ImNickA/AltiumGithub/Karman Delta Arm/Ancillary Data/Vector character.png

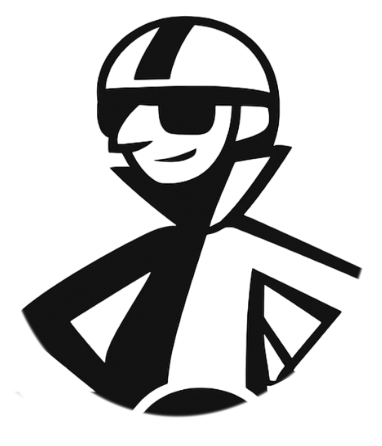
Karman Delta Arm/Ancillary Data/Vector character.png
