ImNickA/AltiumGithub/Karman Delta Arm/Ancillary Data/Altium Templates/BOM Template.xlsx

Sheet: PCB BOM
 | Bill of Materials | Field=a_BomNo
 | Title | Field=a_Title | THIS DRAWING REMAINS THE PROPERTY OF SUNRIDE. COPYRIGHT FOR ALL PURPOSES IS VESTED IN SUNRIDE. THE REPRODUCTION OF THIS DRAWING IN WHOLE OR IN PART IS PROHIBITED WITHOUT EXPRESS CONSENT IN WRITING. THIS DESIGN IS OFFERED FOR USE ONLY WITH EQUIPMENT MANUFACTURED OR SPECIFICALLY RECOMMENDED BY SUNRIDE. RIGHTS ARE RESERVED TO MAKE A CHARGE FOR THE USE OF THIS DESIGN OR ANY PART THEREOF AND SUCH RIGHT SHALL SUBSIST UNLESS AND UNTIL THE SAME SHALL BE EXPRESSLY WAIVED IN WRITING. ACCEPTANCE OF THIS DRAWING WILL BE CONSTRUED AS AN ACCEPTANCE OF THESE CONDITIONS.
 | Version | Field=a_Variant
 | Release Date: | #VALUE!
 | CAD: Altium Designer | Field=a_AltiumVer
 | Copyright | Field=a_CopyrightDate
Item # | Column=Designator | Column=Description | Column=Quantity | Column=Manufacturer Part Number 1 | Column=Manufacturer 1 | Column=Supplier Part Number 1 | Column=Supplier 1 | Column=Fitted | Column=Notes
1
2
3

Sheet: Parameters
Field=a_SchRevDate
Field=a_PcbRevDate
#VALUE! | latest of the two dates
