ImNickA/AltiumGithub/Karman Delta Arm/Rev B/Assembly Outputs/Bill of Materials/KDA Rev B1 PCB BOM.xlsx

Sheet: PCB BOM
 | Bill of Materials | KDA Rev B1
 | Title | Karman Delta V.E.C.T.O.R. Board | THIS DRAWING REMAINS THE PROPERTY OF SUNRIDE. COPYRIGHT FOR ALL PURPOSES IS VESTED IN SUNRIDE. THE REPRODUCTION OF THIS DRAWING IN WHOLE OR IN PART IS PROHIBITED WITHOUT EXPRESS CONSENT IN WRITING. THIS DESIGN IS OFFERED FOR USE ONLY WITH EQUIPMENT MANUFACTURED OR SPECIFICALLY RECOMMENDED BY SUNRIDE. RIGHTS ARE RESERVED TO MAKE A CHARGE FOR THE USE OF THIS DESIGN OR ANY PART THEREOF AND SUCH RIGHT SHALL SUBSIST UNLESS AND UNTIL THE SAME SHALL BE EXPRESSLY WAIVED IN WRITING. ACCEPTANCE OF THIS DRAWING WILL BE CONSTRUED AS AN ACCEPTANCE OF THESE CONDITIONS.
 | Version | Standard
 | Release Date: | 20 Jan 2026
 | CAD: Altium Designer | 26.2.0
 | Copyright | 2026
Item # | Designator | Description | Quantity | Manufacturer Part Number 1 | Manufacturer 1 | Supplier Part Number 1 | Supplier 1 | Fitted | Notes
1 | A1 | PCB (Bare Board) | 1 |  |  | KDA Rev B |  | Fitted | -
2 | C1A, C1B, C2A, C2B, C3A, C3B, C5A, C5B, C7A, C7B, C8A, C8B, C9A, C9B, C10A, C10B, C11A, C11B, C12A, C12B, C12C, C12D, C13A, C13B, C13C, C13D, C14, C15, C16, C18, C19 | Capacitor MLC 100nF 50V X7R 10% CAPC1608X08M | 31 | VJ0603Y104KXACW1BC | Vishay | 2407338 | Farnell | Fitted
3 | C4A, C4B | Capacitor MLC 100uF 6.3V X5R 20% CAPC2012X15M | 2 | GRM21BR60J107ME15L | Murata | 2494476 | Farnell | Fitted
4 | C6A, C6B, C17 | Capacitor MLC 10uF10V X7R 10% CAPC2012X15M | 3 | C0805C106M9RACTU | KEMET | 2821064 | Farnell | Fitted
5 | D8A, D8B | Diode Schottky BAT54C SOT-23 | 2 | BAT54C,215 | Nexperia | 1727-2902-1-ND | DigiKey | Fitted
6 | J1A, J1B, J1C, J1D | Connector 2 Way Mini-Fit 5566 Series | 4 | 39-31-0020 | Molex | 3221778 | Farnell | Fitted
7 | J2, J6 | Connector 6 Way Vertical B06B-PASK-1 (LF) (SN) 2mm Pitch | 2 | B06B-PASK-1(LF)(SN) | JST | 1830743 | Farnell | Fitted
8 | J3A, J3B, J3C, J3D | Connector 2 Way Vertical JST B2P-VH(LF)(SN) 3.96mm Pitch | 4 | B2P-VH(LF)(SN) | JST | 9492003 | Farnell | Fitted
9 | J4A, J4B, J5A, J5B | Connector 10W FFC/FPC 0.5mm SM ZIF | 4 | FH12-10S-0.5SH(55) | HIROSE ELECTRIC | 1324540 | Farnell | Fitted
10 | J7A, J7B, J9 | Connector 4 Way Vertical JST B04B-PASK-1 (LF) (SN) 2mm Pitch | 3 | B04B-PASK-1(LF)(SN) | JST | 1830738 | Farnell | Fitted
11 | J10 | Connector 3 Way Vertical 2mm Pitch | 1 | B03B-PASK-1(LF)(SN) | JST | 1830736 | Farnell | Fitted
12 | LED1A, LED1B | LED RGB, SMD, 2.4mm, 115 ° | 2 | ASMB-MTB0-0B3A2 | Avago | 3653562 | Farnell | Fitted
13 | LED2A, LED2B, LED2C, LED2D | LED 2.0x1.25mm GREEN 0805 LTST-C170KGKT | 4 | LTST-C170KGKT | Lite-On | 160-1414-1-ND | DigiKey | Fitted
14 | Q1A, Q1B, Q1C, Q1D, Q6A, Q6B, Q6C, Q6D | Power MOSFET, P Channel, 30 V, 15.2 A, 0.0111 ohm, MLPAK33, Surface Mount | 8 | PXP012-30QLJ | Nexperia | 3934789 | Farnell | Fitted
15 | Q3A, Q3B, Q3C, Q3D | N-Channel Logic Level Enhancement Mode Field Effect Transistor, 220 mA, 50 V, -55 to 150 degC, 3-Pin SOT-23, RoHS, Tape and Reel | 4 | BSS138 | onsemi | 9845330 | Farnell | Fitted
16 | R1A, R1B, R1C, R1D, R4A, R4B, R4C, R4D, R10A, R10B, R12A, R12B, R12C, R12D, R15, R37A, R37B | SMD Chip Resistor, Thin Film, 10 kohm, 75 V, 0603 [1608 Metric], 100 mW, ± 0.1%, ERA3A Series | 17 | ERA-3AEB103V | Panasonic | 1577619 | Farnell | Fitted
17 | R2A, R2B, R2C, R2D, R11A, R11B, R11C, R11D | SMD Chip Resistor, Thin Film, 30 kohm, 75 V, 0603 [1608 Metric], 100 mW, ± 0.1%, ERA3A Series | 8 | ERA-3AEB303V | Panasonic | 1670196 | Farnell | Fitted
18 | R3A, R3B, R3C, R3D | SMD Chip Resistor, Thick Film, 1 kohm, 50 V, 0603 [1608 Metric], 100 mW, ± 1%, RC Series | 4 | RC0603FR-071KL | Yageo Group | 2421849 | Farnell | Fitted
19 | R5A, R5B, R6A, R6B | Resistor 39R 1% 50V RESC1608X06M | 4 | RC0603FR-0739RL | Yageo Group | 9238310 | Farnell | Fitted
20 | R7A, R7B | Resistor 240R 1% 50V RESC1608X06M | 2 | RC0603FR-07240RL | Yageo Group | 3495779 | Farnell | Fitted
21 | R8A, R8B, R9A, R9B | Resistor 4K7 1% 50V RESC1608X06M | 4 | RC0603FR-074K7L | Yageo Group | 2421876 | Farnell | Fitted
22 | R13, R14, R16, R17 | SMD Chip Resistor, Thick Film, 62 ohm, 75V, 0603 [1608 Metric], 100mW, ± 1%, RC Series | 4 | RC0603FR-0762RL | Yageo Group | 3495893 | Farnell | Fitted
23 | R22A, R22B, R22C, R22D | Resistor 560R 1% 50V RESC1608X06M | 4 | RC0603FR-07560RL | Yageo Group | 9238450 | Farnell | Fitted
24 | SW1A, SW1B, SW2A, SW2B | Switch SMD SPST-NO Vertical ITT/Cannon KSR231GLFS | 4 | KSR231GLFS | C&K Components | 1201422 | Farnell | Fitted
25 | TP1A, TP1B, TP2A, TP2B, TP16A, TP16B, TP21, TP22 | PCB Test Point S1751 Series, Surface Mount | 8 | S1751-46R | Harwin | 952-1478-1-ND | DigiKey | Fitted
26 | U1A, U1B | IC Supply Voltage Monitor, 2.93V TPS3828-33DBVT SOT23-5 | 2 | TPS3828-33DBVR | Texas Instruments | 3008838 | Farnell | Fitted
27 | U2A, U2B | IC REG LIN 3.3V 100MA SOT223-3 | 2 | MIC5200-3.3YS-TR | Microchip | MIC5200-3.3YS-TR | Arrow Electronics | Fitted
28 | U3A, U3B, U5 | IC TRANSCEIVER FULL 1/1 8SOIC | 3 | ISO1042DWV | Texas Instruments | 296-53076-ND | DigiKey | Fitted
29 | U4 | IC Regulator LDO MIC5239-5.0YS SOT-223 | 1 | MIC5239-5.0YS | Microchip | 2510294 | Farnell | Fitted
30 | U6A, U6B | IC MCU 32BIT 16KB FLASH 32LQFP | 2 | STM32L011K4T6 | STMicroelectronics | 2770298 | Farnell | Fitted
31 | Z3A, Z3B | CABLE FFC/FPC 10POS 0.5MM 4" | 2 | 151660101 | Molex | WM11300-ND | DigiKey | Fitted

Sheet: Parameters
20 Jan 2026
20 Jan 2026
20 Jan 2026 | latest of the two dates
