ImNickA/AltiumGithub/Karman Delta Arm/Rocket arming system.xlsx

Sheet: Requirements
Req No | Requirement | Detail | Min | Typ | Max | Units | Notes
 | General
 | Operating Voltage | Suitable for 1x or 2 x LiPo cell battery packs | 3.7 |  | 10 | V
 | Current (quiescent) | Quiescent current per power domain (drawn by each uC, RS485 transceiver & LEDs). Majority of this is the RS385 transceivers & indicator LEDs |  |  | 30 | mA
 | Shock |  |  |  | TBD
 | Vibration |  |  |  | TBD
 | Temperature |  | -20 |  | 85 | °C
 | Humidity |  |  |  | TBD |  | Add conformal coating
 | Load current | Current per output channel |  |  | 3 | A
 | Number of Primary batteries |  | 2
 | Number of Primary outputs |  | 2
 | Number of Backup batteries |  | 2
 | Number of Backup outputs |  | 2
 | Distance from rocket to control PC for safety | Length of cable to be driven by RS485 | 10 |  | TBD | m | Should be able to do ~1km - depends on Baud rate. TBD
 | Isolation voltage between domains |  | 4000 |  |  | V
 | Functionality
 | Must have full electrical isolation between primary, backup and communications power domains | External event in any domain must not affect other domains |  |  |  |  | System divided into 3 totally isolated circuitry domains - Primary, Backup & comms. Any fault in one domain must not ripple through to other domains | Residual risk of ESD strike affecting flight controller & Arming PCB at same time
 | Must power up with outputs OFF by default | No voltage on outputs at any time |  |  |  |  | As batteries are connected, there must be no chance of the flight controllers being energised
 | Must boot up with outputs OFF | No voltage on outputs at any time |  |  |  |  | During uC boot, O/Ps are usually pulled Hi by high value resistor inside uC. This must not turn on the output stages
 | Must keep outputs OFF during programming / reset | No voltage on outputs at any time |  |  |  |  | During uC reset/programming, O/Ps are usually pulled Hi by high value resistor inside uC. This must not turn on the output stages
 | Must only turn outputs on when commanded
 | Must turn outputs OFF when commanded
 | Must be able to enable/disable Ultimate Arm when comms are connected | Command can be sent to enable/disable Ultimate Arm
 | Must monitor a heartbeat message sent to confirm comms is active | If comms interrupted then outputs turn OFF (unless set to Ultimate Arm) |  |  |  |  | Needed so it is safe to approach rocket - power automatically turns off if comms lost.
 | Must ignore heartbeat when in Ultimate Arm state | Ultimate Arm state maintains states of outputs even with no comms (when magnetic connector disconnects upon launch) |  |  |  |  | Needed so power is not turned off after launch when comms cable detaches
 | Must have uC status LEDs | Need to visually show what mode it is in (On, Armed, Ultimate Arm, Error etc) |  |  |  |  | RGB LEDS needed during assembly to show status. Could be switched off for launch to save power.
 | Must have output state LEDs | To indicate when a given output is switched on.
 | Must be brown our resistant | Must reset cleanly when uC voltage drops to avoid unexpected behaviour.
 | Must monitor & report all battery voltages | Transmit individual battery voltages back to control PC
 | Must power each uC (primary and backup) from diode combined batteries (only in that domain) | Diode-OR combination of each of the batteries within primary domain powers primary uC. Same for backup uC. Ensures each uC runs from the highest voltage battery in each domain
 | Must maintain independence of each battery for individual outputs | Batteries must not be combined for outputs
 | All connectors must be polarised and latching | Avoids reverse connection and prevents accidental disconnection
 | Input and output connections must be different | Avoids possibility of incorrect connection
 | Must be tolerant to reverse polarity connection of a battery | Diodes on all battery connections
 | Must maintain and transmit incrementing count of time since power applied (1 sec res) | Shows time since last reset and proves comms is alive
 | Must have debug serial port | Need to have debug serial port for SW development |  |  |  |  | Allows human readable text to be displayed on a terminal program during SW dev.
 | Must have programming header |  |  |  |  |  | Connects to STM32 programmer via pogo pins
 | PCB tracking & components must handle max short circuit current of battery pack | Current limiting to be done by battery packs |  |  |  |  | Short circuit current limit managed by battery packs
 | Control PC
 | Must allow control of individual output stages
 | Must display status of individual output stages | Show OFF / ARMED
 | Must display status of comms link | Response to heartbeat
 | Must display time since reset for each uC
 | Must display Ultimate Arm status | Show OFF / ULTIMATE ARMED
 | Must display Ultimate Arm time countdown
 | Nice To Have
 | Should be Arduino-esque | Ideally have Arduino deployed as framework for SW development

Sheet: SW Functions
Flash version No at startup on status LED
Message handling
CH1 ON
CH1 OFF
CH2 ON
CH2 OFF
CH3 ON
CH3 OFF
CH4 ON
CH4 OFF
Ultimate Arm
Ultimate disarm
Status
Heartbeat
Battery voltage measurement
Status LED
Debug serial
Output sense measurement
Heartbeat loss = disarm unless in ultimate arm

Sheet: FMEA
No | Failure Mode | Hazard | Worst case consequence | Severity Score | Likelihood score | RBM | Mitigation | Remaining Risk | Severity Score | Likelihood score | RAM | Notes
1 | Failure of Primary power domain system, causing failure of power to primary flight controller system. | Loss of function | Failed flight | 1 | 2 | 2 | Secondary power domain fully independent so secondary flight controller operates as intended | None |  |  |  | Flight controller has no safety system. Software not written to safety standards.
2 | Failure of arming system causes unintended O/P activation |  |  |  |  | 0
3 | Failure of comms |  |  |  |  | 0
4 | Battery goes flat |  |  |  |  | 0
5 | Launch before ultimate arming of O/Ps - so O/Ps go off when comms failure detected |  |  |  |  | 0 | Launch checklist
6 | Launch before top stage ready |  |  |  |  | 0
7 |  |  |  |  |  | 0
8 |  |  |  |  |  | 0
9 |  |  |  |  |  | 0
10 |  |  |  |  |  | 0
11 |  |  |  |  |  | 0
12 |  |  |  |  |  | 0
13 |  |  |  |  |  | 0
14
 |  |  | Low Severity or Low Liklihood | 1
 |  |  |  | 2
 |  |  |  | 3
 |  |  |  | 4
 |  |  | High Severity or High Liklihood | 5
 |  |  | <=2 = OK
 |  |  | >2 = Med
 |  |  | >9 = High

Sheet: TO DO
To Do | Done | Notes
Add programming connector | a
Add O/P senses to uC | a
Check Load Currents | a
Add status LED & O/P state LEDs | a
Add POR | a
MCAD link | r
Add mating connectors in unmated positions in 3D | r
Add PCB part No inc BOM entry | a
Add layer idents | a
Back annotate | r
Consider board shape - leaving cutout to allow removal without disassembling rocket centre tube. | r
Add gate pot down resistors to protect P fet Vgs | a
Add decouplers to Vsense lines | a
Check ADC I/P Z
Sort multiple symbols for same parts | a
Change 0.1% resistor symbol to rectangle | a
Add PCB templates | a
Sort pull down resistors (internal uC pull up is nominal 45K, 25K min) | a
Add CAN line terminators | a
Add conformal coating layers | r
Sort Outjobs | a
Redo board shape to allow for external switches & debug headers | a
Change P FETS to higher current devices | a
Change mounting holes to isolated | r
Add domain ident blob links | a
Sort problems with Tag Connect footprint - keepouts & mech size | a
Finish tracking | a
Full rules check | a
Routing layer 2mm cutter tool path | a
Drawing notes | a
PCB Number - change from XXXXXX | a
Sort designators | a
Sort assembly layer designators | a
Get standard stackup from PCB manuf | a
Sort BomDoc | a
Sort BOM Excel template | a
Remove parts under compile mask | a
Setup rules re domain separation | r
Small gap to pass wires through (middle of iso area) | a
Tent vias | a
Stitching vias | r
Solder blobs showing as short circuit and not working with copper pour | a
Turn back on rules temporarily disabled | a
Investigate CAN | a
Label Inputs & Outputs | a
Check Poly Fills for unconnected copper | a
Redo logo cutout to increase breakout size | a
Sort route tool path for centre hole | a

Sheet: Problems
Problem | Details | Identified by Initials & Date | Problem Found In | Fixed by Initial & Date | Problem Fixed In | Notes
Spelling on Keyfob | Should read "Karman Delta" | ACB 15 Dec 2025 | Rev A | ACB 28 Dec 2025 | Rev B
Magnitude and direction | Should read Direction and Magnitude | ACB 15 Dec 2025 | Rev A | ACB 28 Dec 2025 | Rev B
C8B | Too close to through hole metal pin of programming header | ACB 15 Dec 2025 | Rev A | ACB 28 Dec 2025 | Rev B
D8B | Overlaps connector | ACB 15 Dec 2025 | Rev A | ACB 28 Dec 2025 | Rev B
U3B | Designator visible - overlaps pads | ACB 15 Dec 2025 | Rev A | ACB 28 Dec 2025 | Rev B
OUT_P1 | Silkscreen truncated | ACB 15 Dec 2025 | Rev A | ACB 28 Dec 2025 | Rev B
Ancillaries schematic template | Bottom left logo wrong | ACB 15 Dec 2025 | Rev A | ACB 28 Dec 2025 | Rev B
Via tenting | Not all vias tented | ACB 15 Dec 2025 | Rev A | ACB 19 Jan 2026 | Rev B
Board edge clearance | Tracks & holes too close to board edge. Create new rule | ACB 15 Dec 2025 | Rev A | ACB 1 Jan 2026 | Rev B
Blob links unnecessary | Remove blob links | ACB 15 Dec 2025 | Rev A | ACB 10 Jan 2026 | Rev B
PFETs wrong | Drain Source swapped on symbol | ACB 15 Dec 2025 | Rev A | ACB 10 Jan 2026 | Rev B
3V3 connection on serial debug | PCB 3V3 clash with 3V3 from FTDI lead - disconect | ACB 15 Dec 2025 | Rev A | ACB 10 Jan 2026 | Rev B
Programming adaptor breakout | RX TX crossed - rewire | ACB 15 Dec 2025 | Rev A | ACB 10 Jan 2026 | Rev B
Status LED too bright | Reduce current in all RGB LEDs | ACB 15 Dec 2025 | Rev A | ACB 10 Jan 2026 | Rev B
Concern about bulk capacitance | Increase C4 to 100uF | ACB 15 Dec 2026 | Rev A | ACB 10 Jan 2026 | Rev B
Check Net Class directives on SCM | Had been corrupted. Needs to be re-entered | ACB 15 Dec 2026 | Rev A | ACB 10 Jan 2026 | Rev B
Sort BOM - new parts | Add part solutions | ACB 15 Dec 2026 | Rev A | ACB 19 Jan 2026 | Rev B
CAN adaptor 9V I/P | Needs connector rather than test points | ACB 15 Dec 2026 | Rev A | ACB 11 Jan 2026 | Rev B
Dates
Conformal coating | Add conformal coating mask layers to assembly drawings | ACB 15 Dec 2025 | Rev A
NOT GOING TO CHANGE NOW
Surge current | Check e-match igniton current profile | ACB 15 Dec 2025 | Rev A |  |  | 2A for 4mS. FETs ok, but need to check battery voltage dip during firing. Would be alieviated by using both batteries on primary and secondary (ie 4 batteries)
Brown out reset | Check uC bulk capacitance needed | ACB 15 Dec 2025 | Rev A |  |  | As above
Cost of multiple designs per PCB | Only do main PCB - delete ancillaries & keyfob | ACB 15 Dec 2025 | Rev A
CAN connector | Could split out each CAN bus and link in external connector. Thereby breaking the link between the processors as flight starts. Use existing 6 way connector. NEED TO CHANGE CAN ADAPTOR ALSO | ACB 15 Dec 2025 | Rev A
CAN peripheral not on current uC | Can peripheral on uC would make programming comms easier | ACB 15 Dec 2025 | Rev A
Boot address | Check default boot address so don't have to set option bytes. Possibly invert BOOT | ACB 15 Dec 2025 | Rev A |  |  | Easier to just add note on schematic to program Option Bits
Camera connector | Add 2 way header via 1k resistor | ACB 15 Dec 2025 | Rev A |  |  | Ground box doesn't have ability to switch this

Sheet: Bits to purchase
Item | Qty | Manuf | Manuf Part No | Supplier | Supplier Part No | Link | Notes | Ordered
M8 Nut - Reny | 2 | ACCU | HPN-M8-RENY-BL | ACCU | HPN-M8-RENY-BL | https://www.accu.co.uk/hexagon-nuts/655625-HPN-M8-RENY-BL | M8 glass reinforced Nylon - non conductive nut | r
Battery pack connector receptacle | 4 | Molex | 39012025 | Farnell | 2101989 | https://uk.farnell.com/molex/39-01-2025/connector-housing-rcpt-2pos/dp/2101989 | Mates with 39-31-0020 Molex MiniFit Jnr | a
Battery pack crimp | 8 | Molex | 45750-1112 | Farnell | 1717550 | https://uk.farnell.com/molex/45750-1112/contact-socket-18awg-crimp/dp/1717550 |  | Already got
Output connector receptacle | 4 | JST | VHR-2N | Farnell | 630470 | https://uk.farnell.com/jst-japan-solderless-terminals/vhr-2n/crimp-housing-2way-3-96mm/dp/630470 | Mates with B2P-VH(LF)(SN) JST VH Series | a
Output crimp | 8 | JST | BVH-21T-P1.1 | Farnell | 630500 | https://uk.farnell.com/jst-japan-solderless-terminals/bvh-21t-p1-1/crimp-socket-0-33-0-83mm/dp/630500 |  | a
CAN connector receptacle | 1 | JST | PAP-06V-S | Farnell | 1830730 | https://uk.farnell.com/jst-japan-solderless-terminals/pap-06v-s/connector-housing-pa-6way-2mm/dp/1830730 | Mates with B06B-PASK-1 (LF) (SN) JST PA series | a
CAN crimp | 6 | JST | SPHD-002T-P0.5 | Farnell | 1830725 | https://uk.farnell.com/jst-japan-solderless-terminals/sphd-002t-p0-5/crimp-socket-24-28awg/dp/1830725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 |  | Already got
Serial connector receptacle | 3 | JST | PAP-04V-S | Farnell | 1830729 | https://uk.farnell.com/jst-japan-solderless-terminals/pap-04v-s/connector-housing-rcpt-4pos-2mm/dp/1830729 | Mates with B04B-PASK-1 (LF) (SN) 4 JST PA series | Already got
Serial crimp | 12 | JST | SPHD-002T-P0.5 | Farnell | 1830725 | https://uk.farnell.com/jst-japan-solderless-terminals/sphd-002t-p0-5/crimp-socket-24-28awg/dp/1830725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 |  | Already got
PP3 battery clip | 1 |  |  |  |  |  |  | a
Dev Kit
ST-Link programmer | 1 | ST Micro | ST-LINK/V2 | Farnell | 1892523 | https://uk.farnell.com/stmicroelectronics/st-link-v2/icd-programmer-for-stm8-stm32/dp/1892523
Adaptor PCB | 1 | Tag Connect | ARM20-CTX | Debug Store | ARM20-CTX | https://thedebugstore.com/products/tag-connect-arm20-ctx-20-pin-to-tc2030-idc-adapter-uk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
Tag Connect programming header | 1 | Tag Connect | TC2030-CTX-NL-ST14 | Debug Store | TC2030-CTX-NL-ST14 | https://thedebugstore.com/products/tag-connect-tc2030-ctx-nl-st14-stm32-swd-programming-cable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
USB to serial lead | 3 | FTDI | TTL-232RG-VREG3V3-WE | Farnell | 2352005 | https://uk.farnell.com/ftdi/ttl-232rg-vreg3v3-we/cable-ttl-usb-conv-wire-end-3v3/dp/2352005 | NO STOCK
Dev boards | 2 | ST Micro | Nucleo-L011K4 | Farnell | 2535699 | https://uk.farnell.com/stmicroelectronics/nucleo-l011k4/dev-board-nucleo-32-mcu/dp/2535699 |  | a
Consumables
Flux pen |  | CHEMTRONICS | CW8400 | Farnell | 9599568 | https://uk.farnell.com/chemtronics/cw8400/dispensing-pen-flux-lead-free/dp/9599568
Solder |  |  |  |  |  |  | 60/40 Sn/Pb
Flux-off |  | CHEMTRONICS | ES835BE | Farnell | 860414 | https://uk.farnell.com/chemtronics/es835be/cleaner-flux-off-200ml/dp/860414
Lint free cloths |  | MULTICOMP PRO | MP015562 | Farnell | 4668791 | https://uk.farnell.com/multicomp-pro/mp015562/clean-room-wiper-100x100mm-150sheet/dp/4668791
Anti-static bags (metalised)
Cotton buds (wooden)
Peelable Mask |  | TECHSPRAY | 2211-8SQ | Farnell | 2501338 | https://uk.farnell.com/techspray/2211-8sq/solder-mask-peelable-wondermask/dp/2501338 | For masking connectors & switches before conformal coating
Conformal coating |  | ELECTROLUBE | APL400H | Farnell | 3026838 | https://uk.farnell.com/electrolube/apl400h/coating-conformal-acrylic/dp/3026838 | Acrylic Protective Lacquer
Threadlock 222 |  | Loctite | 222, 10ML | Farnell | 537056 | https://uk.farnell.com/loctite/222-10ml/threadlocker-bottle-10ml-purple/dp/537056 | Keeps nut in place - saves having to over-tighten
IPA |  |  |  |  |  |  | Iso-Propyl Alcohol
Solder Wick
Tip Cleaner/Tinner
Brass wire tip cleaner
Tools
Tweezers |  | WELLER EREM (https://uk.farnell.com/c/tools-production-supplies/tools-hand-workholding/tweezers?brand=weller-erem) | 5SASL | Farnell | 1014356 | https://uk.farnell.com/erem/5sasl/tweezer-economic-115mm/dp/1014356 | Fine tip
Loupes |  |  |  | Ebay |  | https://www.ebay.co.uk/itm/388292280633 | Use x3.5 magnification

Sheet: Ignitor current
Current profile of ignitors
 | #1 | #2 | #3 | Firing run
DC resistance measured on DVM (Ω) | 2.28 | 2.13 | 2.22 | #1
lead set (Ω) to be subtracted | 0.75 | 0.75 | 0.75
Ignitor (Ω) | 1.53 | 1.38 | 1.47
 |  |  |  | #2
 |  |  |  | #3

Sheet: Lessons Learned
Problem | Root Cause | Possible avoidance measures | Notes

Sheet: Calculations
O/P LED resistor
LED Forward voltage (V) | 2
Supply voltage (V) | 7.4
LED current (mA) | 10
Load resistor (Ohm) | 540
Resistor power (W) | 0.054
O/P voltage sense
Top R (KOhm) | 30
Bottom R (KOhm) | 10
Out Voltage (V) | 7.4
Sense Voltage (V) | 1.85
RGB LED | R | G | B
LED Forward voltage (V) | 2.1 | 3.1 | 3.1
Supply voltage (V) | 3.3 | 3.3 | 3.3
LED current (mA) | 5 | 5 | 5
Load resistor (Ohm) | 240 | 40 | 40
Resistor power (W) | 0.006 | 0.001 | 0.001
Capacitance for firing |  |  | Capacitance needed to source O/P current
Firing current (A) | 2
Firing Duration (mS) | 4
Voltage dip (V) | 0.1
Capacitance required (F) | 0.08 |  | Not going to add that much capacitance - is better done by having secondary battery
Capacitance required (uF) | 80000 |  | I=CdV/dt | C=Idt/dV
uC bulk capacitance |  |  | Capacitance needed on 3V3 line to prevent uC brown out during firing
uC current (A) | 0.05
Firing Duration (mS) | 4
Voltage dip (V) | 0.1
Capacitance required (F) | 0.002
Capacitance required (uF) | 2000 |  | Not going to add that much capacitance - is better done by having secondary battery
Firing current limiting |  |  | Add resistance to ignitor lead to reduce current surge from battery
Ignitor resistance (ohm) | 1.6
Ignitor firing current (A) | 0.4
Battery voltage (V) | 3.7
Total resistance needed | 9.25 |  | Total circuit resistance to draw ignitor current
Series R needed (ohm) | 7.65 |  | Resistance to add in series with ignitor
 |  |  |  |  | c

Sheet: uC pinout
Pin number |  |  |  |  |  |  | Pin name (function after reset) | Pin type | I/O structure | Notes | Pin functions
TSSOP14 | UFQFPN20 | TSSOP20 | UFQFPN28 | LQFP32 | UFQFPN32 (1) | WLCSP25 |  |  |  |  | Alternate functions | Additional functions | Usage
2 | 1 | 2 | 2 | 2 | 2 | B5 | PC14- | I/O | FT | - | - | OSC32_IN | OUT_EN_6
 |  |  |  |  |  |  | OSC32_IN
3 | 2 | 3 | 3 | 3 | 3 | C5 | PC15- | I/O | TC | - | - | OSC32_OUT | LED_RED
 |  |  |  |  |  |  | OSC32_OUT
4 | 3 | 4 | 4 | 4 | 4 | D5 | NRST | I/O | RST | -2 | - | -
10 | 4 | 5 | 5 | 5 | 5 | C4 | VDDA | S | - | (3)(4) | - | -
5 | 5 | 6 | 6 | 6 | 6 | E5 | PA0-CK_IN | I/O | TTa | - | USART2_RX, | COMP1_INM, | LED_GREEN
 |  |  |  |  |  |  |  |  |  |  | LPTIM1_IN1, | ADC_IN0,
 |  |  |  |  |  |  |  |  |  |  | TIM2_CH1, | RTC_TAMP2/WKU
 |  |  |  |  |  |  |  |  |  |  | USART2_CTS, TIM2_ETR, | P1/CK_IN
 |  |  |  |  |  |  |  |  |  |  | LPUART1_RX,
 |  |  |  |  |  |  |  |  |  |  | COMP1_OUT
6 | 6 | 7 | 7 | 7 | 7 | B4 | PA1 | I/O | FT | - | EVENTOUT, | COMP1_INP,
 |  |  |  |  |  |  |  |  |  |  | LPTIM1_IN2, | ADC_IN1
 |  |  |  |  |  |  |  |  |  |  | TIM2_CH2,
 |  |  |  |  |  |  |  |  |  |  | I2C1_SMBA,
 |  |  |  |  |  |  |  |  |  |  | USART2_RTS_DE,
 |  |  |  |  |  |  |  |  |  |  | TIM21_ETR,
 |  |  |  |  |  |  |  |  |  |  | LPUART1_TX
- | - | 8 | 8 | 8 | 8 | D4 | PA2 | I/O | TTa | - | TIM21_CH1, TIM2_CH3, | COMP2_INM,
 |  |  |  |  |  |  |  |  |  |  | USART2_TX, | ADC_IN2, | BATT_SENSE_5
 |  |  |  |  |  |  |  |  |  |  | LPUART1_TX, | RTC_TAMP3/RTC_
 |  |  |  |  |  |  |  |  |  |  | COMP2_OUT | TS/RTC_OUT/WKU P3
- | - | 9 | 9 | 9 | 9 | E4 | PA3 | I/O | FT | - | TIM21_CH2, | COMP2_INP,
 |  |  |  |  |  |  |  |  |  |  | TIM2_CH4, | ADC_IN3
 |  |  |  |  |  |  |  |  |  |  | USART2_RX,
 |  |  |  |  |  |  |  |  |  |  | LPUART1_RX
7 | 7 | 10 | 10 | 10 | 10 | B3 | PA4 | I/O | TTa | - | SPI1_NSS, | COMP1_INM,
 |  |  |  |  |  |  |  |  |  |  | LPTIM1_IN1, | COMP2_INM,
 |  |  |  |  |  |  |  |  |  |  | LPTIM1_ETR, I2C1_SCL, | ADC_IN4 | BATT_SENSE_1
 |  |  |  |  |  |  |  |  |  |  | USART2_CK,
 |  |  |  |  |  |  |  |  |  |  | TIM2_ETR,
 |  |  |  |  |  |  |  |  |  |  | LPUART1_TX,
 |  |  |  |  |  |  |  |  |  |  | COMP2_OUT
- | 8 | 11 | 11 | 11 | 11 | D3 | PA5 | I/O | TTa | - | SPI1_SCK, | COMP1_INM,
 |  |  |  |  |  |  |  |  |  |  | LPTIM1_IN2, | COMP2_INM,
 |  |  |  |  |  |  |  |  |  |  | TIM2_ETR, | ADC_IN5 | BATT_SENSE_2
 |  |  |  |  |  |  |  |  |  |  | TIM2_CH1
- | 9 | 12 | 12 | 12 | 12 | E3 | PA6 | I/O | FT | - | SPI1_MISO, | ADC_IN6 | OUT_SENSE_1
 |  |  |  |  |  |  |  |  |  |  | LPTIM1_ETR,
 |  |  |  |  |  |  |  |  |  |  | LPUART1_CTS,
 |  |  |  |  |  |  |  |  |  |  | EVENTOUT,
 |  |  |  |  |  |  |  |  |  |  | COMP1_OUT
8 | 10 | 13 | 13 | 13 | 13 | C3 | PA7 | I/O | FT | - | SPI1_MOSI, | COMP2_INP,
 |  |  |  |  |  |  |  |  |  |  | LPTIM1_OUT,
 |  |  |  |  |  |  |  |  |  |  | USART2_CTS, | ADC_IN7 | OUT_SENSE_2
 |  |  |  |  |  |  |  |  |  |  | TIM21_ETR,
 |  |  |  |  |  |  |  |  |  |  | EVENTOUT,
 |  |  |  |  |  |  |  |  |  |  | COMP2_OUT
- | - | - | 14 | 14 | 14 | E2 | PB0 | I/O | FT | - | EVENTOUT, | ADC_IN8, | OUT_EN_1
 |  |  |  |  |  |  |  |  |  |  | SPI1_MISO, | VREF_OUT
 |  |  |  |  |  |  |  |  |  |  | TIM2_CH2,
 |  |  |  |  |  |  |  |  |  |  | USART2_RTS_DE,
 |  |  |  |  |  |  |  |  |  |  | TIM2_CH3
- | 11 | 14 | 15 | 15 | 15 | D2 | PB1 | I/O | FT | - | USART2_CK, | ADC_IN9, | OUT_EN_2
 |  |  |  |  |  |  |  |  |  |  | SPI1_MOSI, | VREF_OUT
 |  |  |  |  |  |  |  |  |  |  | LPTIM1_IN1,
 |  |  |  |  |  |  |  |  |  |  | LPUART1_RTS_DE
 |  |  |  |  |  |  |  |  |  |  | , TIM2_CH4
- | - | - | - | - | 16 | - | PB2 | I/O | FT | - | LPTIM1_OUT | -
9 | 12 | 15 | 16 | 16 | - | E1 | VSS | S | - | -5 | - | -
10 | 13 | 16 | 17 | 17 | 17 | D1 | VDD | S | - | -6 | - | -
- | - | - | 18 | 18 | 18 | C1 | PA8 | I/O | FT | - | MCO, LPTIM1_IN1, | - | LED_BLUE
 |  |  |  |  |  |  |  |  |  |  | EVENTOUT,
 |  |  |  |  |  |  |  |  |  |  | USART2_CK,
 |  |  |  |  |  |  |  |  |  |  | TIM2_CH1
11 | 14 | 17 | 19 | 19 | 19 | B1 | PA9 | I/O | FTf | - | MCO, I2C1_SCL, | -
 |  |  |  |  |  |  |  |  |  |  | LPTIM1_OUT,
 |  |  |  |  |  |  |  |  |  |  | USART2_TX,
 |  |  |  |  |  |  |  |  |  |  | TIM21_CH2, COMP1_OUT
12 | 15 | 18 | 20 | 20 | 20 | C2 | PA10 | I/O | FTf | -7 | TIM21_CH1, I2C1_SDA, | -
 |  |  |  |  |  |  |  |  |  |  | RTC_REFIN,
 |  |  |  |  |  |  |  |  |  |  | USART2_RX,
 |  |  |  |  |  |  |  |  |  |  | TIM2_CH3,
 |  |  |  |  |  |  |  |  |  |  | COMP1_OUT
- | - | - | - | 21 | 21 | - | PA11 | I/O | FT | - | SPI1_MISO, | -
 |  |  |  |  |  |  |  |  |  |  | LPTIM1_OUT, EVENTOUT,
 |  |  |  |  |  |  |  |  |  |  | USART2_CTS,
 |  |  |  |  |  |  |  |  |  |  | TIM21_CH2, COMP1_OUT
- | - | - | - | 22 | 22 | - | PA12 | I/O | FT | - | SPI1_MOSI, | -
 |  |  |  |  |  |  |  |  |  |  | EVENTOUT,
 |  |  |  |  |  |  |  |  |  |  | USART2_RTS_DE,
 |  |  |  |  |  |  |  |  |  |  | COMP2_OUT
13 | 16 | 19 | 21 | 23 | 23 | A1 | PA13 | I/O | FTf | - | SWDIO, | -
 |  |  |  |  |  |  |  |  |  |  | LPTIM1_ETR,
 |  |  |  |  |  |  |  |  |  |  | I2C1_SDA,
 |  |  |  |  |  |  |  |  |  |  | SPI1_SCK,
 |  |  |  |  |  |  |  |  |  |  | LPUART1_RX,
 |  |  |  |  |  |  |  |  |  |  | COMP1_OUT
14 | 17 | 20 | 22 | 24 | 24 | A2 | PA14 | I/O | FT | -7 | SWCLK, | -
 |  |  |  |  |  |  |  |  |  |  | LPTIM1_OUT,
 |  |  |  |  |  |  |  |  |  |  | I2C1_SMBA,
 |  |  |  |  |  |  |  |  |  |  | USART2_TX,
 |  |  |  |  |  |  |  |  |  |  | SPI1_MISO,
 |  |  |  |  |  |  |  |  |  |  | LPUART1_TX,
 |  |  |  |  |  |  |  |  |  |  | COMP2_OUT
- | - | - | 23 | 25 | 25 | - | PA15 | I/O | FT | - | SPI1_NSS, | -
 |  |  |  |  |  |  |  |  |  |  | TIM2_ETR,
 |  |  |  |  |  |  |  |  |  |  | EVENTOUT,
 |  |  |  |  |  |  |  |  |  |  | USART2_RX,
 |  |  |  |  |  |  |  |  |  |  | TIM2_CH1
- | - | - | 24 | 26 | 26 | B2 | PB3 | I/O | FT | - | SPI1_SCK, | COMP2_INM | CAMERA_ENABLE
 |  |  |  |  |  |  |  |  |  |  | TIM2_CH2,
 |  |  |  |  |  |  |  |  |  |  | EVENTOUT
- | - | - | 25 | 27 | 27 | - | PB4 | I/O | FT | - | SPI1_MISO, EVENTOUT | COMP2_INP
- | - | - | 26 | 28 | 28 | - | PB5 | I/O | FT | - | SPI1_MOSI, | COMP2_INP
 |  |  |  |  |  |  |  |  |  |  | LPTIM1_IN1,
 |  |  |  |  |  |  |  |  |  |  | I2C1_SMBA,
 |  |  |  |  |  |  |  |  |  |  | TIM21_CH1
- | 18 | - | 27 | 29 | 29 | A3 | PB6 | I/O | FTf | - | USART2_TX, I2C1_SCL, | COMP2_INP
 |  |  |  |  |  |  |  |  |  |  | LPTIM1_ETR,
 |  |  |  |  |  |  |  |  |  |  | TIM2_CH3,
 |  |  |  |  |  |  |  |  |  |  | LPUART1_TX
- | 19 | - | 28 | 30 | 30 | A4 | PB7 | I/O | FTf | - | USART2_RX, I2C1_SDA, | COMP2_INP, VREF_PVD_IN
 |  |  |  |  |  |  |  |  |  |  | LPTIM1_IN2, TIM2_CH4,
 |  |  |  |  |  |  |  |  |  |  | LPUART1_RX
1 | 20 | 1 | 1 | 31 | 31 | A5 | PB9-BOOT0 | I | B | - | - | BOOT0 (Boot memory selection)
- | - | - | - | - | 32 | - | PB8 | I/O | FTf | - | USART2_TX, | -
 |  |  |  |  |  |  |  |  |  |  | EVENTOUT,
 |  |  |  |  |  |  |  |  |  |  | I2C1_SCL,
 |  |  |  |  |  |  |  |  |  |  | SPI1_NSS
- | - | - | - | 32 | - | - | VSS | S | - | -5 | - | -
- | - | - | - | 1 | 1 | - | VDD | S | - | -6 | - | -

Sheet: New Parts
Manuf Part No | Description | Schematic Symbol | Footprint | 3D Step | Supplier Part No | Supplier | Datasheet | Cost x1
sd-datapower-8-l (https://coda-systems.co.uk/product/swift-dock-spring-loaded-multipoint-docking-connectors/swift-dock-data/sd-datapower-8-l/)
