ImNickA/AltiumGithub/Karman Delta Arm/Ancillary Data/sunride rocket outline.dxf

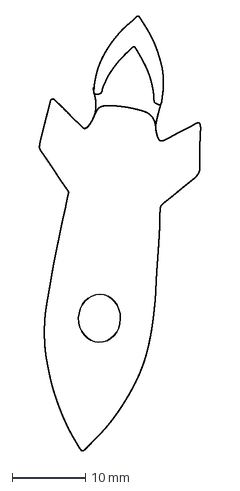
[picture p2: CAD file, 2025-11-08]
Karman Delta Arm/Ancillary Data/sunride rocket outline.dxf
22.0 x 59.5 mm
