ImNickA/AltiumGithub/Karman Delta Arm/Rev B/Assembly Outputs/Step File/KDA Rev B.step

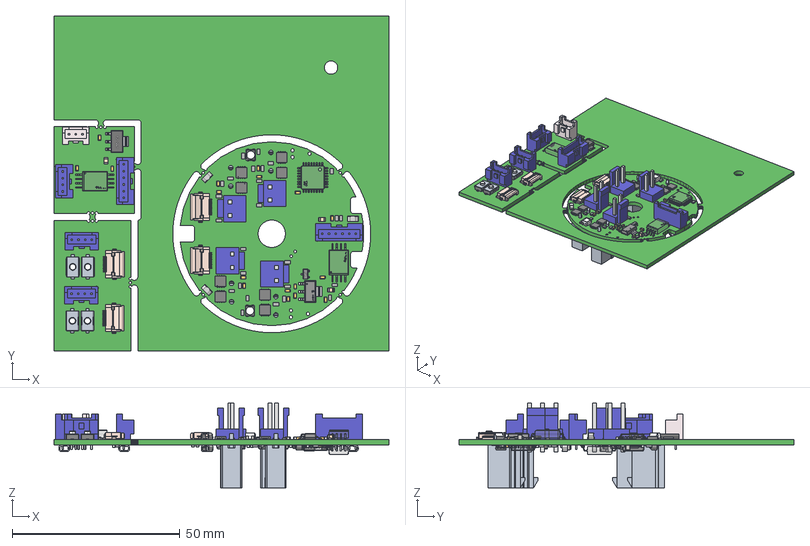
[picture p3: CAD file, 2026-01-28]
Karman Delta Arm/Rev B/Assembly Outputs/Step File/KDA Rev B.step
100.0 x 100.0 x 25.3 mm
B03B-PASK-1_RGB13486297
IC_BODY x 5
circle x 5
IC_LEG x 76
Texas Instruments x 3
IC_LEG_MIR9 x 12
User Library-SOT-223-3
s1751-46r x 8
User Library-RESC1608X05N x 47
Extruded x 53
B04B-PASK-1 x 3
B06B-PASK-1 x 2
User Library-Chip Capacitor2CAPC1608X86N x 31
User Library-CAPC2012X___CAPC2012X145N x 5
FH12-10S-0.5SH__X_8A_S_H_X_97_S__ x 4
STMicroelectronics x 2
Microchip x 2
User Library-SOT23-5-3_Free-Models003 x 2
User Library-SOT23-5-3_Fusion x 2
ASMB-MTB0-0A3A2 x 2
User Library-SOT95P240X110-3M[SOT23-3_TO-236AB] x 2
Leader x 12
User Library-CAPC2012X___CAPC2012X110N x 4
B2P-VH x 4
