ImNickA/AltiumGithub/(list of files, cad)

Other CAD files:
Karman Delta Arm/Rev A/Assembly Outputs/Step File/KDA Rev A.step
