ImNickA/AltiumGithub/Karman Delta Arm/Ancillary Data/Altium Templates/Assembly Release Authorisation.xlsx

Sheet: Approvals
Release Date:
#VALUE! |  |  |  | © OP SUPPORT LTD
 |  |  |  | Field=a_CopyrightDate
Document Title | Field=a_Title | - Assembly Release Authorisation
Document Number | Field=a_AssemRelAuthNo |  | Page No | 1 of 3
Field=a_Title
Assembly Release Authorisation
Name | Role | Signature | Date
 |  |  | (dd Mmm yyyy)
Authored by:
Field=a_SchRevAuthor | Senior Electronics Engineer
Approved by:
THIS DRAWING REMAINS THE PROPERTY OF OP SUPPORT LTD. COPYRIGHT FOR ALL PURPOSES IS VESTED IN OP SUPPORT LTD. THE REPRODUCTION OF THIS DRAWING IN WHOLE OR IN PART IS PROHIBITED WITHOUT EXPRESS CONSENT IN WRITING. THIS DESIGN IS OFFERED FOR USE ONLY WITH EQUIPMENT MANUFACTURED OR SPECIFICALLY RECOMMENDED BY OP SUPPORT LTD. RIGHTS ARE RESERVED TO MAKE A CHARGE FOR THE USE OF THIS DESIGN OR ANY PART THEREOF AND SUCH RIGHT SHALL SUBSIST UNLESS AND UNTIL THE SAME SHALL BE EXPRESSLY WAIVED IN WRITING. ACCEPTANCE OF THIS DRAWING WILL BE CONSTRUED AS AN ACCEPTANCE OF THESE CONDITIONS.

Sheet: Revision Record
Release Date:
#VALUE! |  |  |  |  |  | © OP SUPPORT LTD
 |  |  |  |  |  | Field=a_CopyrightDate
Document Title | Field=a_Title |  | - Assembly Release Authorisation
Document Number | Field=a_AssemRelAuthNo |  |  |  | Page No | 2 of 3
Revision History
Date | Release Rev | Revised By |  | Reason For Revision
#VALUE! | #VALUE! | Field=a_SchRevAuthor |  | Field=a_SchRevReason
Please paste to this line and below all lines from previous revisions of this document

Sheet: Package
Release Date:
#VALUE! |  |  |  |  | © OP SUPPORT LTD
 |  |  |  |  | Field=a_CopyrightDate
Document Title | Field=a_Title |  | - Assembly Release Authorisation
Document Number | Field=a_AssemRelAuthNo |  |  | Page No | 3 of 3
1. Objectives This document defines all of the information and processes required to manufacture and test the specified electronic Printed Circuit Board (PCB) to a defined build level. As such, it represents the highest level of document and starting point for the PCB. 2. Design Package The following information defines all of the design artefacts that, together, are to be used when manufacturing the assembled PCB.
PCB Design Package
Block Diagram |  | Field=a_BlockDiagramNo
Schematic Drawing |  | Field=a_SchDwgNo
Bill Of Materials |  | Field=a_BomNo
Assembly Drawing |  | Field=a_AssemDwgNo
Test Specifications & Procedure |  | Field=a_TestSpecNo
PCBA Notes |  | Field=a_PcbaNotesNo
Note the PCB is issued separately and is called up on the BOM.
Referenced Documents
Document Reference | Title

Sheet: Parameters
Values Passed | Paramater Name | Description
Field=a_AssemDwgNo | a_AssemDwgNo | PCB Assembly Drawing
Field=a_BlockDiagramNo | a_BlockDiagramNo | PCB Block Diagram
Field=a_BomNo | a_BomNo | PCB Bill Of Materials
Field=a_CopyrightDate | a_CopyrightDate | Copyright Year
Field=a_AssemRelAuthNo | a_AssemRelAuthNo | Assembly Release Authorisation Document Number
Field=a_PcbaNotesNo | a_PcbaNotesNo | PCBA Notes
Field=a_PcbPartNo | a_PcbPartNo | PCB Artwork
Field=a_PcbRevAuthor | a_PcbRevAuthor | PCB Revision Author
Field=a_PcbRevDate | a_PcbRevDate | PCB Revision Date
Field=a_PcbRevReason | a_PcbRevReason | PCB Revision Reason
Field=a_Title | a_Title | PCB Title
Field=a_SchDwgNo | a_SchDwgNo | PCB Schematic Drawing No
Field=a_SchRevAuthor | a_SchRevAuthor | Schematic Revision Author
Field=a_SchRevDate | a_SchRevDate | Schematic Revision Date
Field=a_SchRevReason | a_SchRevReason | Schematic Revision Reason
Field=a_TestSpecNo | a_TestSpecNo | PCB Test Specifications & Procedure
#VALUE! | n/a | latest of the Schematic/Pcb Revision Date
