ImNickA/AltiumGithub/Karman Delta Arm/Rev B/Assembly Outputs/Assembly Drawing/KDA Rev B1.PDF

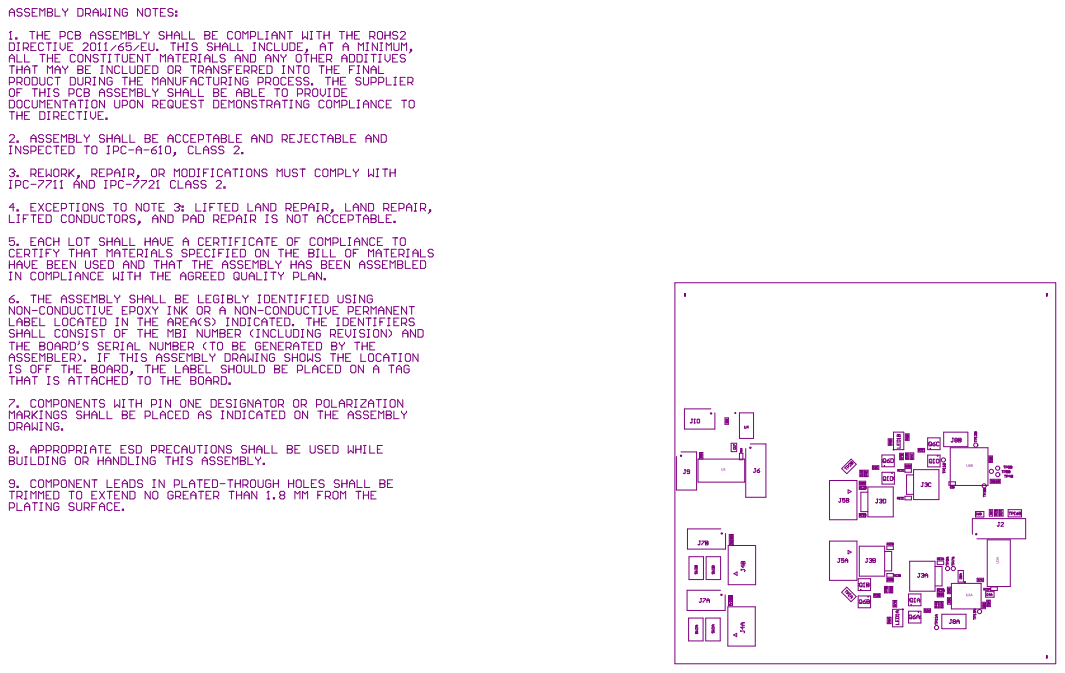
[picture p9: page 1]

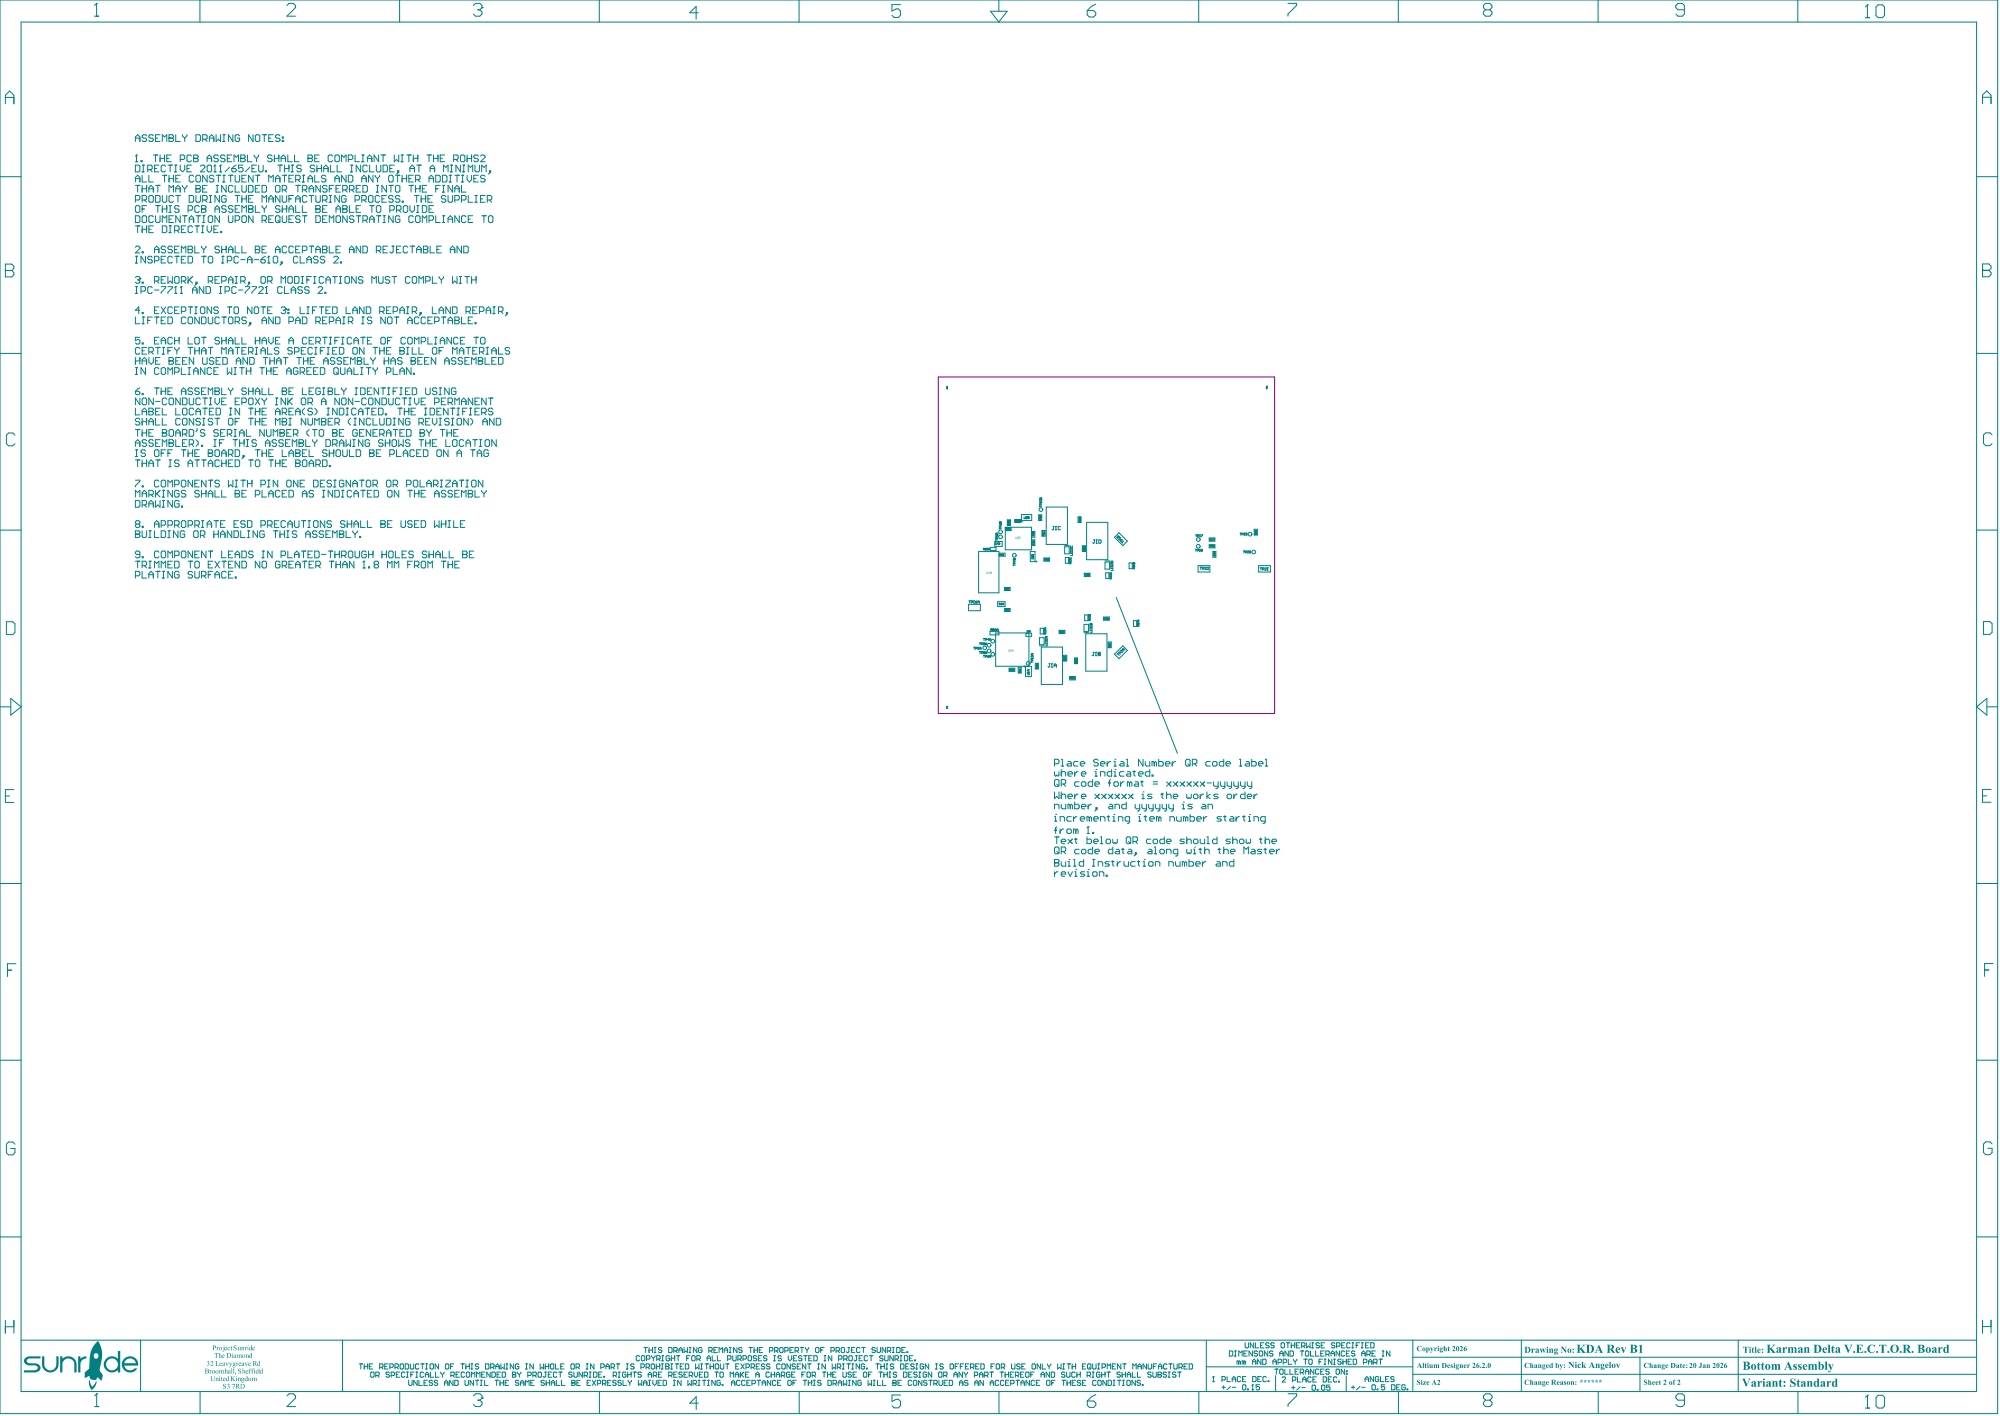
[picture p10: page 2]
