ImNickA/AltiumGithub/Karman Delta Arm/Rev A/Assembly Outputs/Schematic/KDA Rev A1.PDF

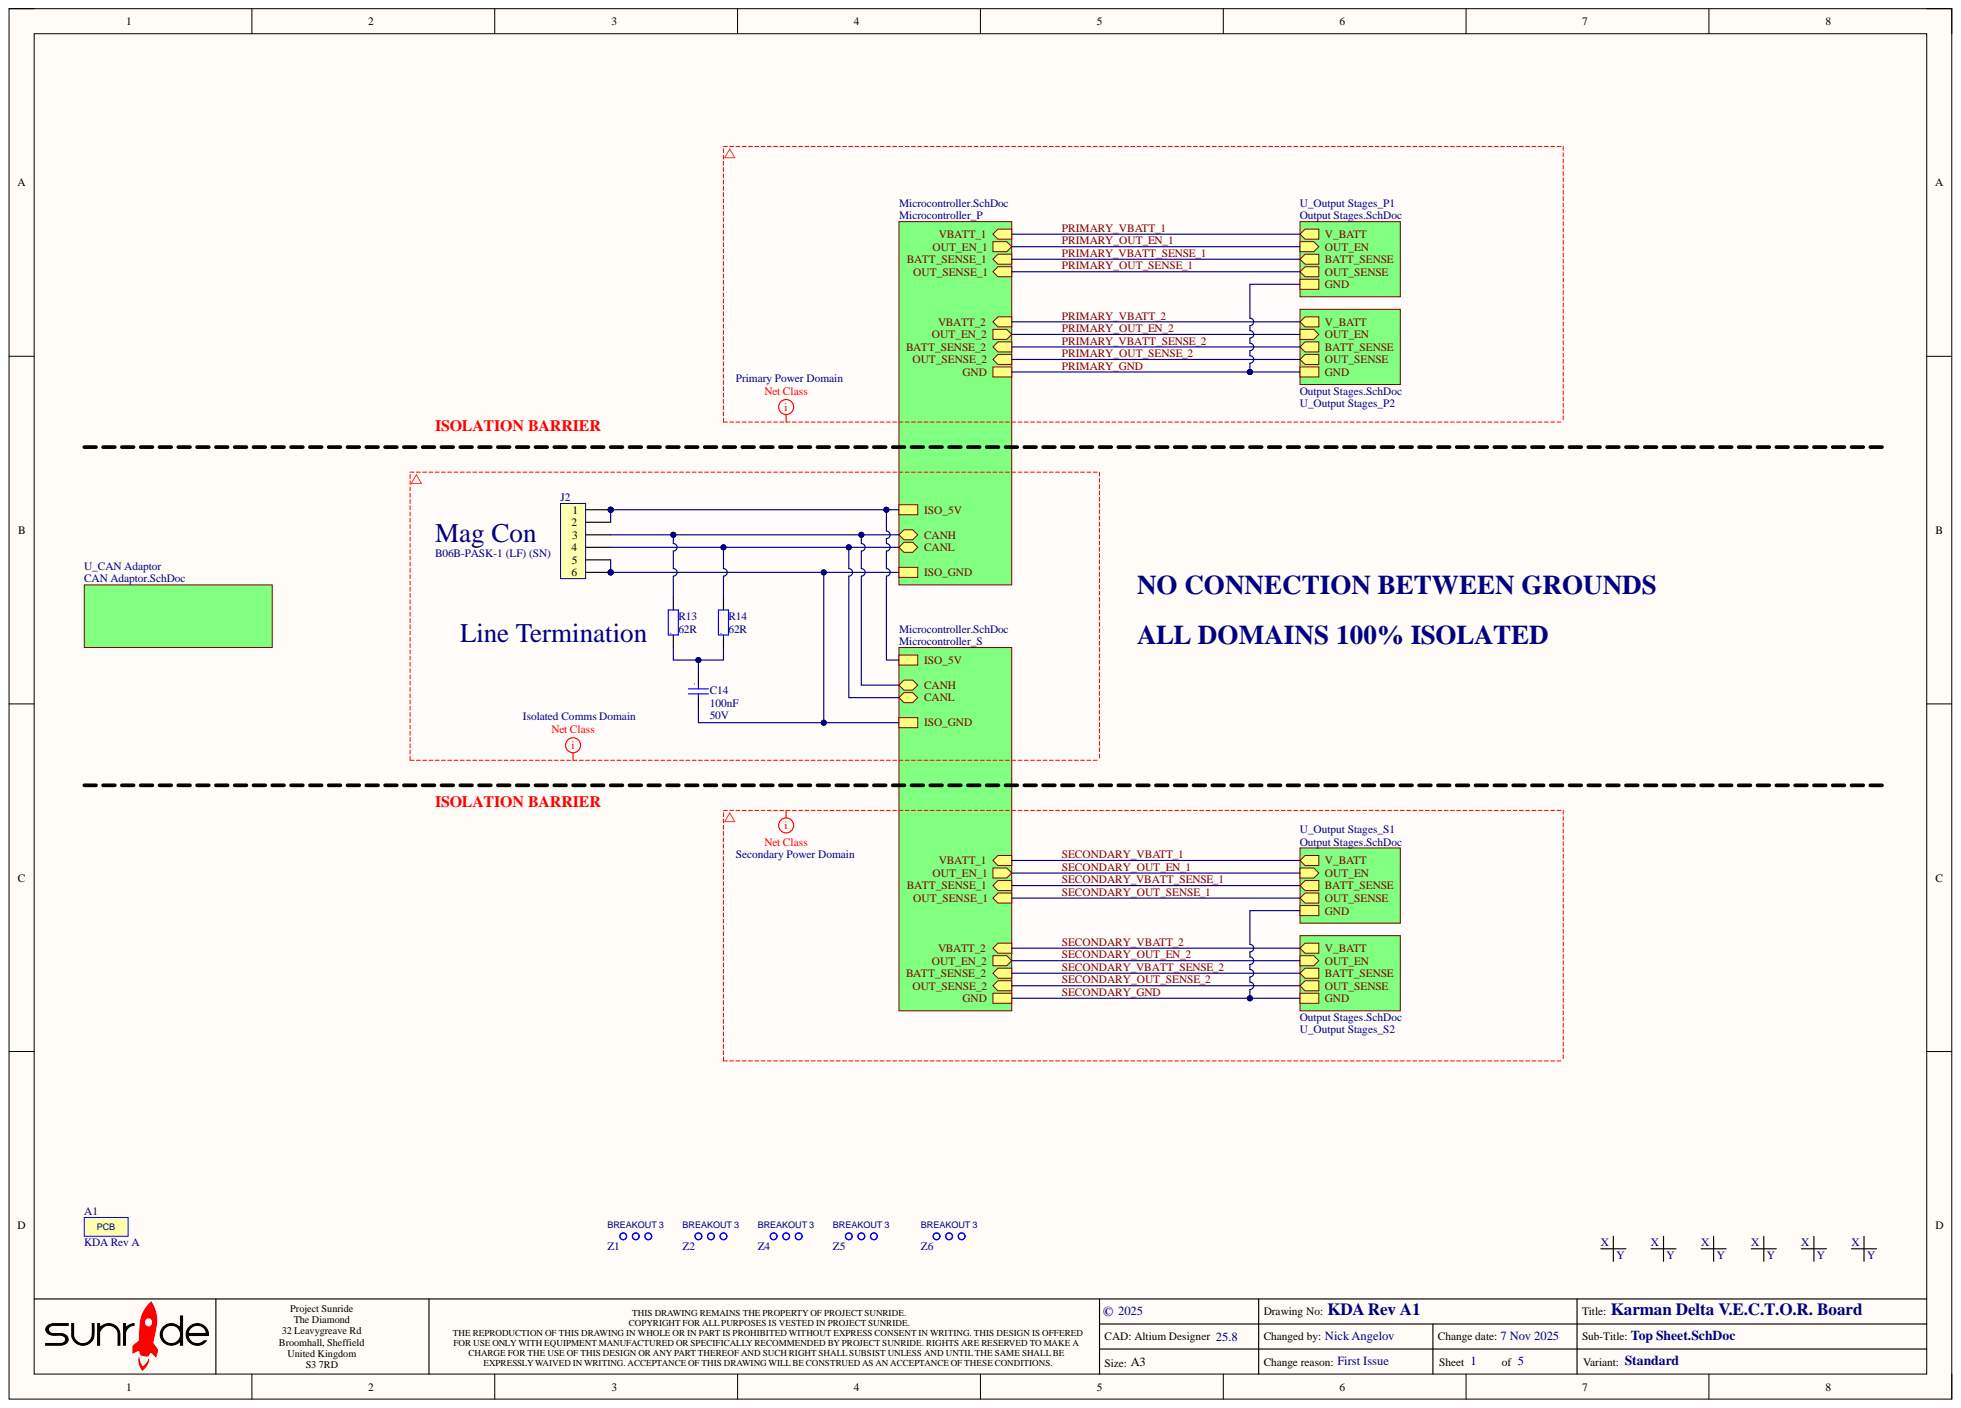
[picture p24: page 1]

NO CONNECTION BETWEEN GROUNDS

THE
FOR USE ONLY WI

THIS DESIGN OR ANY

RUED AS AN AC

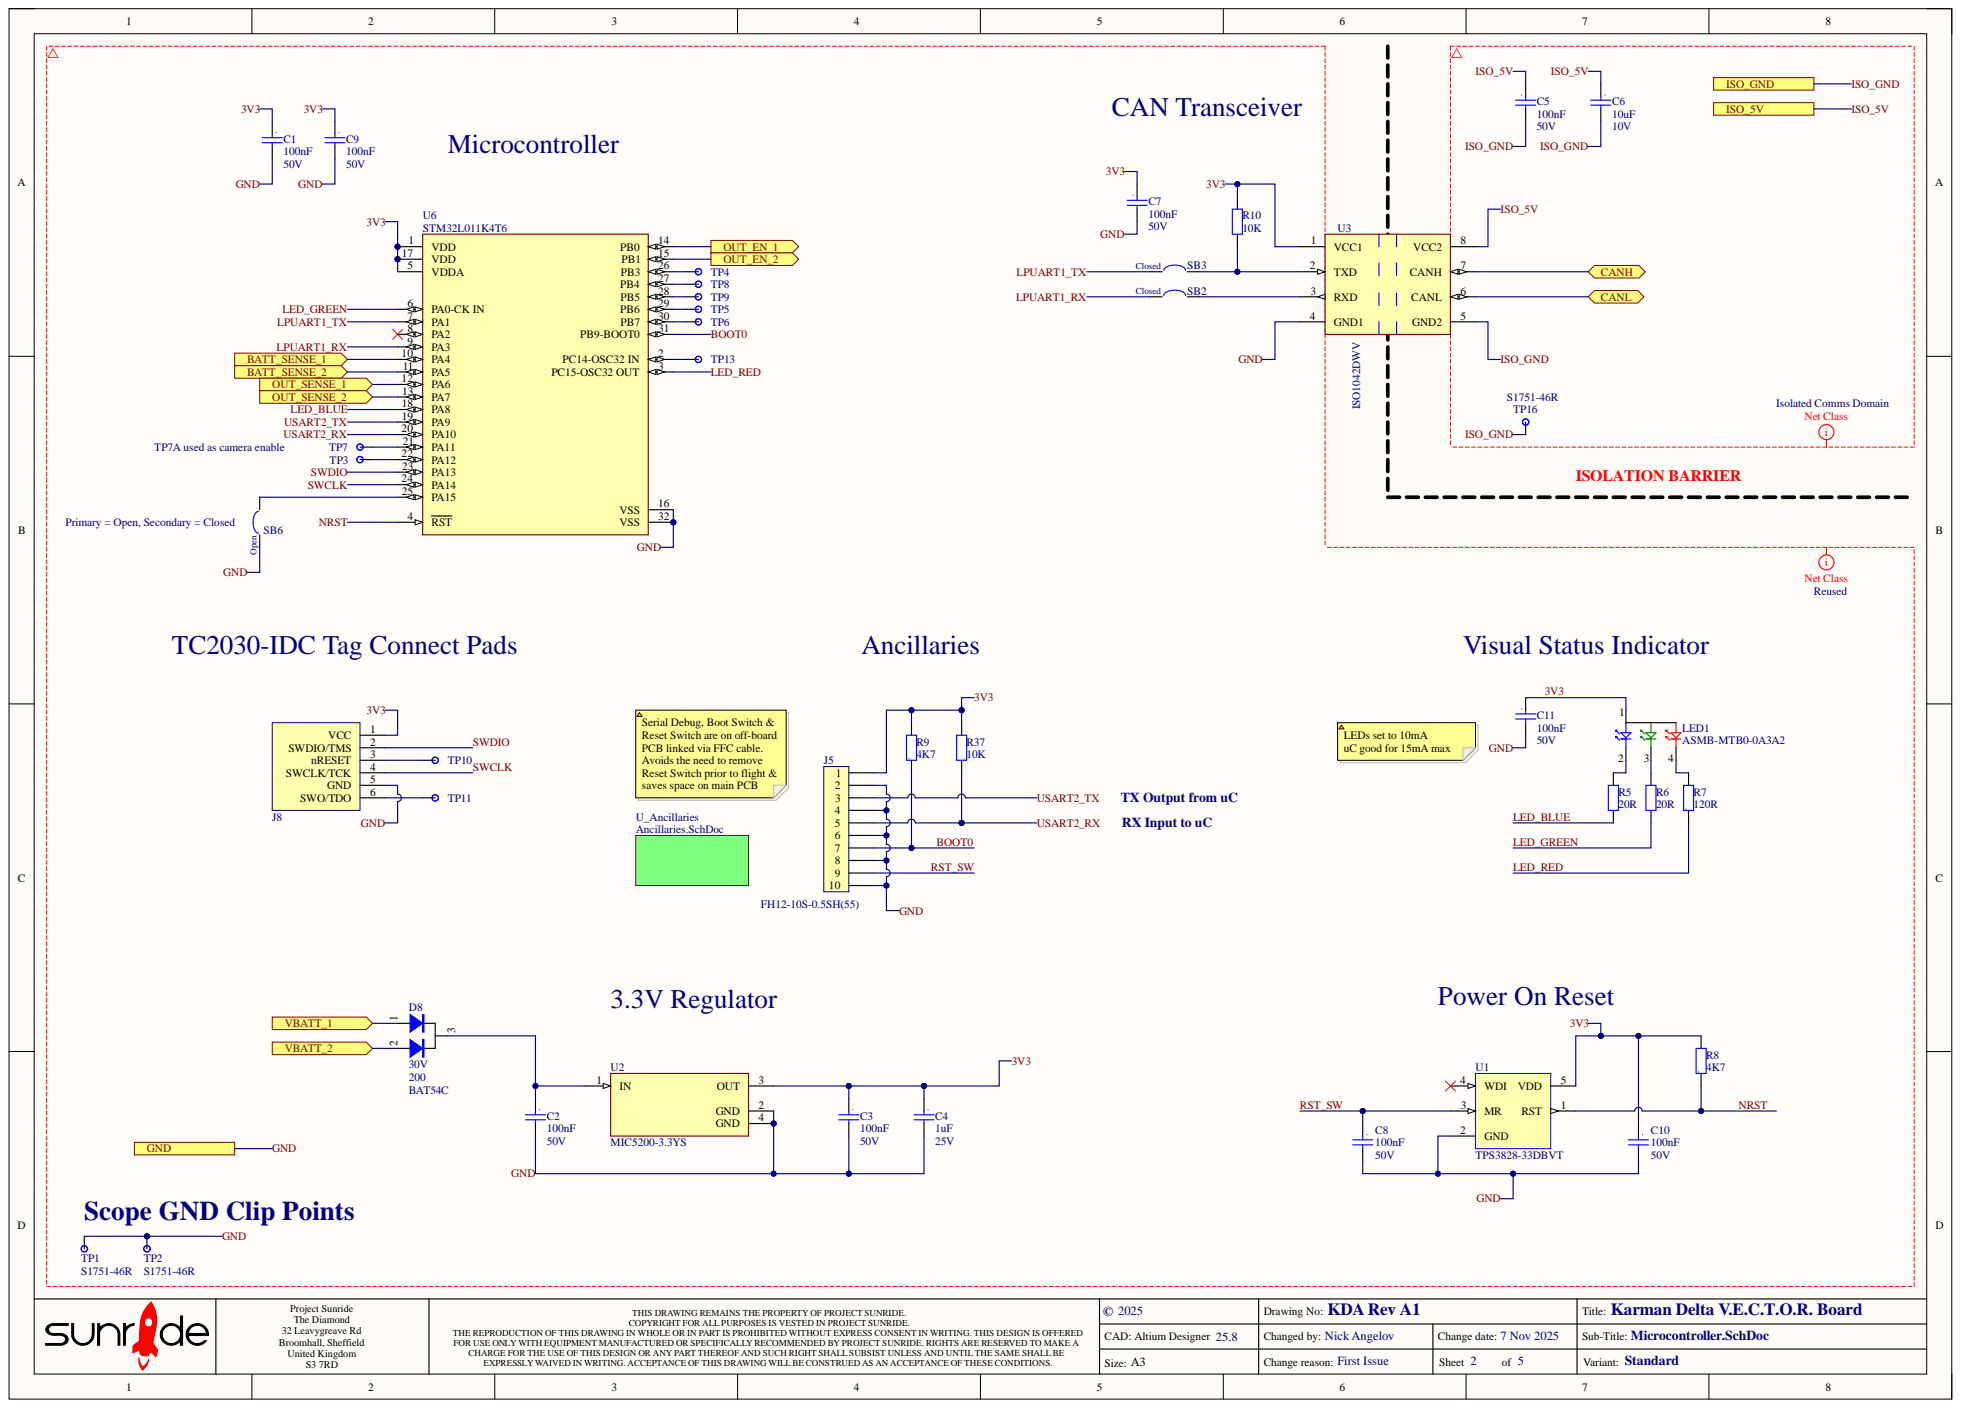
[picture p25: page 2]

SB6 Primary = Open, Secondary = Closed

TC2030-IDC Tag Connect Pads

Serial Debug, Boot Switch &
Reset Switch are on off-board
PCB linked via FFC cable.
Avoids the need to remove
Reset Switch prior to flight &
saves space on main PCB

LEDs set to 10mA
uC good for 15mA max

TX Output from uC

RX Input to uC

Scope GND Clip Points

THIS DRAWING REMAINS THE PROPERTY OF PROJECT SUNRIDE.
COPYRIGHT FOR ALL PURPOSES IS VESTED IN PROJECT SUNRIDE.

Title: Karman Delta V.E.C.T.O.R. Board

THE REPRODUCTION OF THIS DRAWING IN WHOLE OR IN PART IS PROHIBITED WITHOUT EXPRESS CONSENT IN WRITING. THIS DESIGN IS OFFERED
FOR USE ONLY WITH EQUIPMENT MANUFACTURED OR SPECIFICALLY RECOMMENDED BY PROJECT SUNRIDE. RIGHTS ARE RESERVED TO MAKE A
CHARGE FOR THE USE OF THIS DESIGN OR ANY PART THEREOF AND SUCH RIGHT SHALL SUBSIST UNLESS AND UNTIL THE SAME SHALL BE
EXPRESSLYWAIVED IN WRITING. ACCEPTANCE OF THIS DRAWING WILLBE CONSTRUED AS AN ACCEPTANCE OF THESE CONDITIONS.

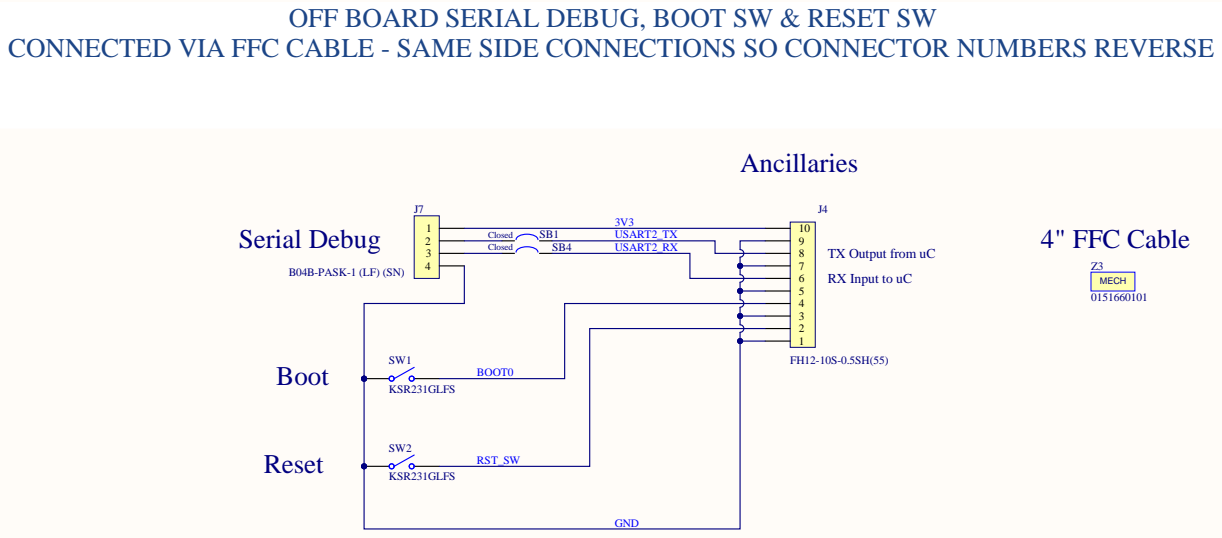
[picture p26: page 3]

OFF BOARD SERIAL DEBUG, BOOT SW & RESET SW

CONNECTED VIA FFC CABLE - SAME SIDE CONNECTIONS SO CONNECTOR NUMBERS REVERSE

TX Output from uC

RX Input to uC

THE
FOR USE ONLY WI

THIS DESIGN OR ANY

RUED AS AN AC

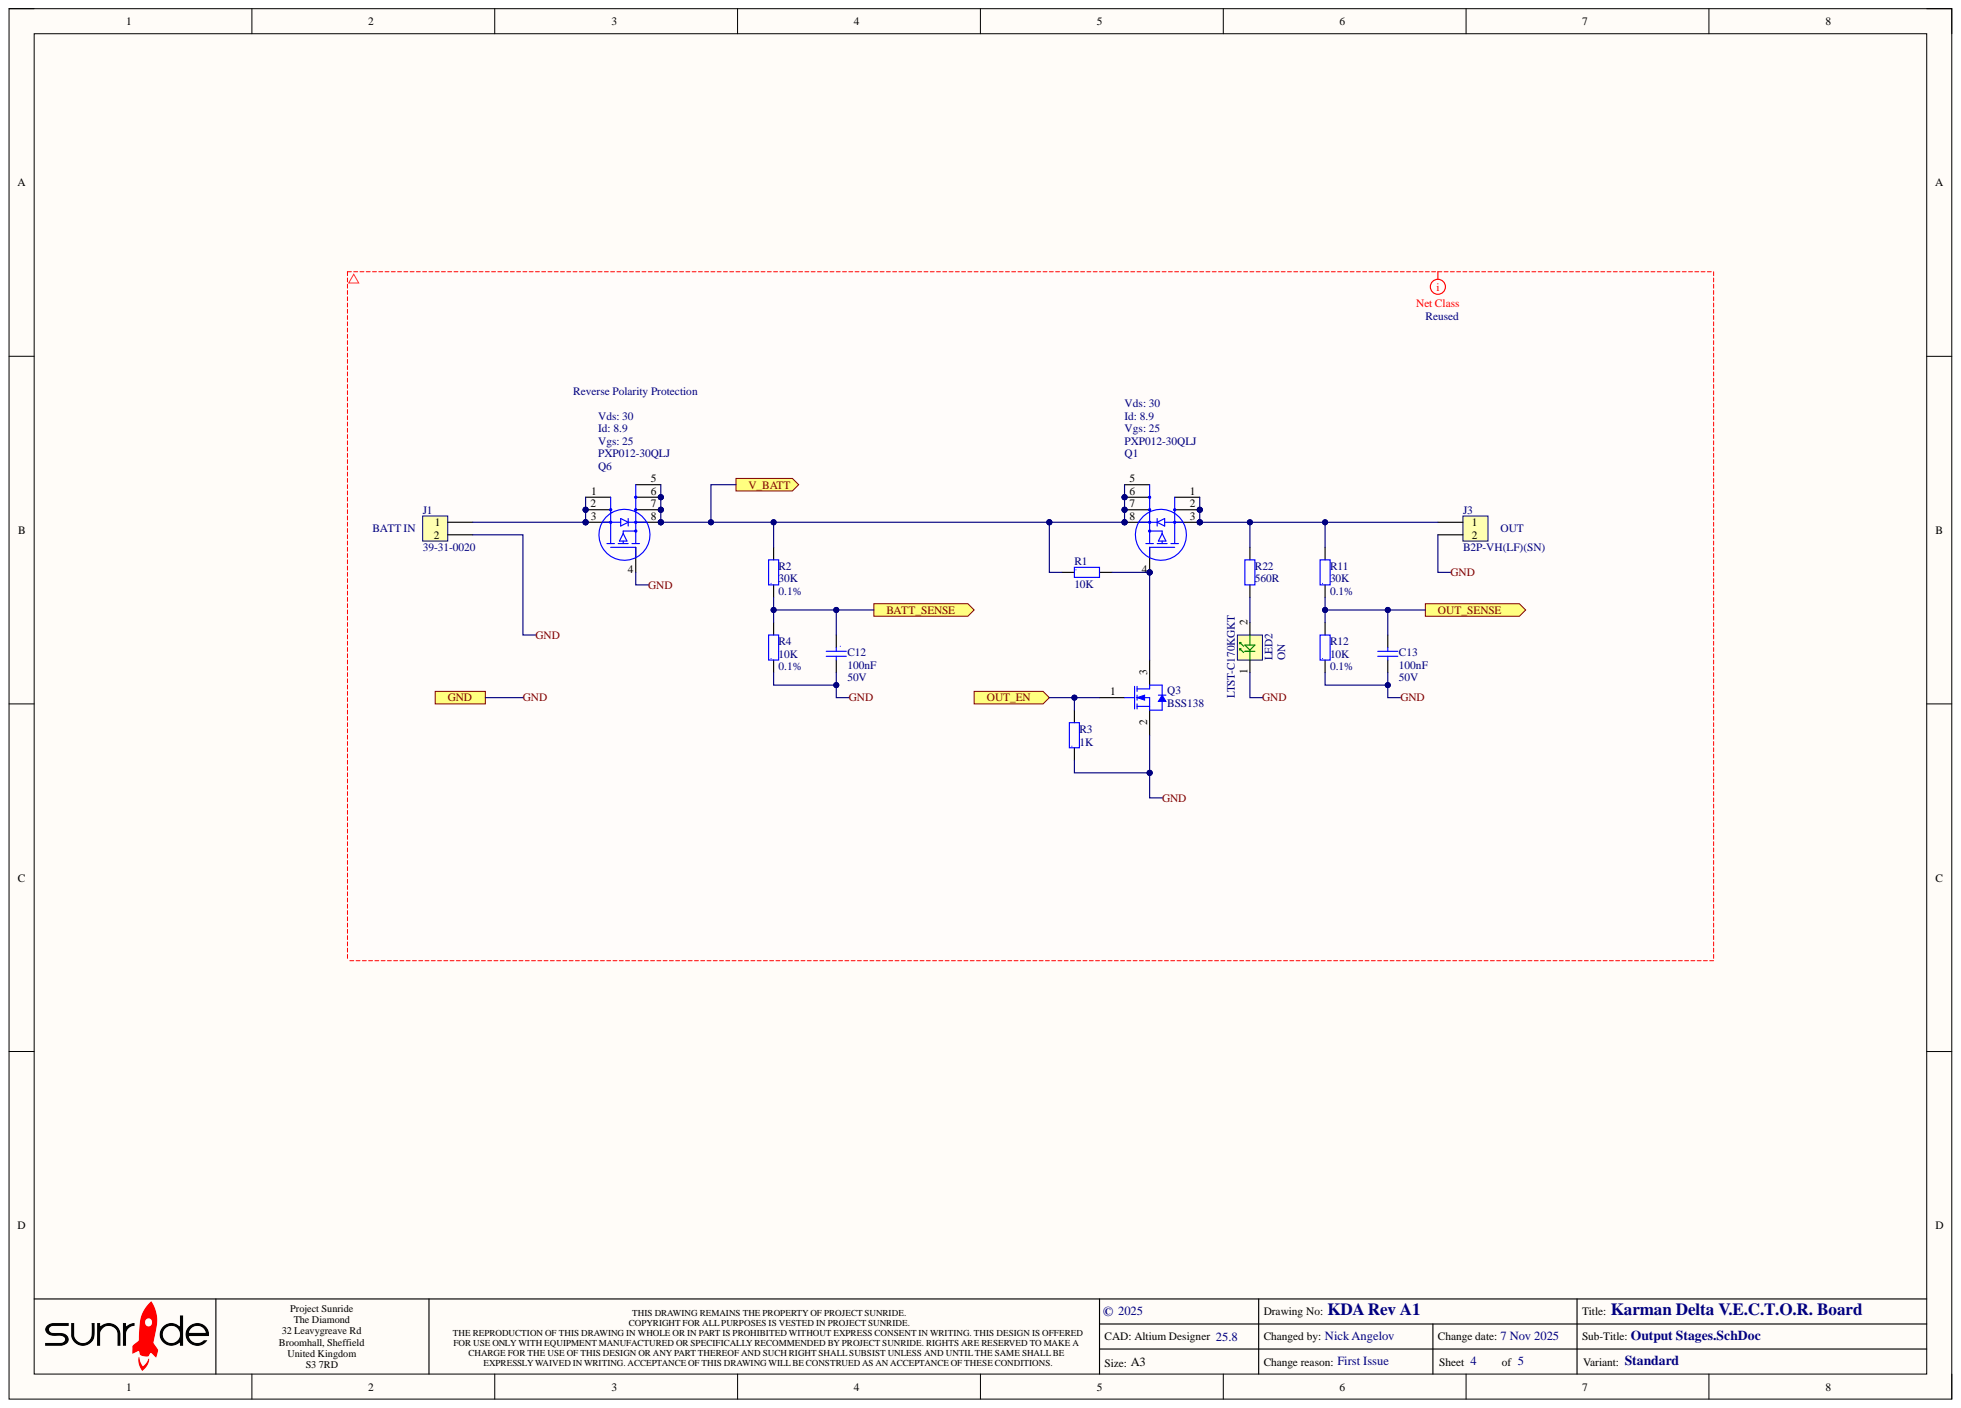
[picture p27: page 4]

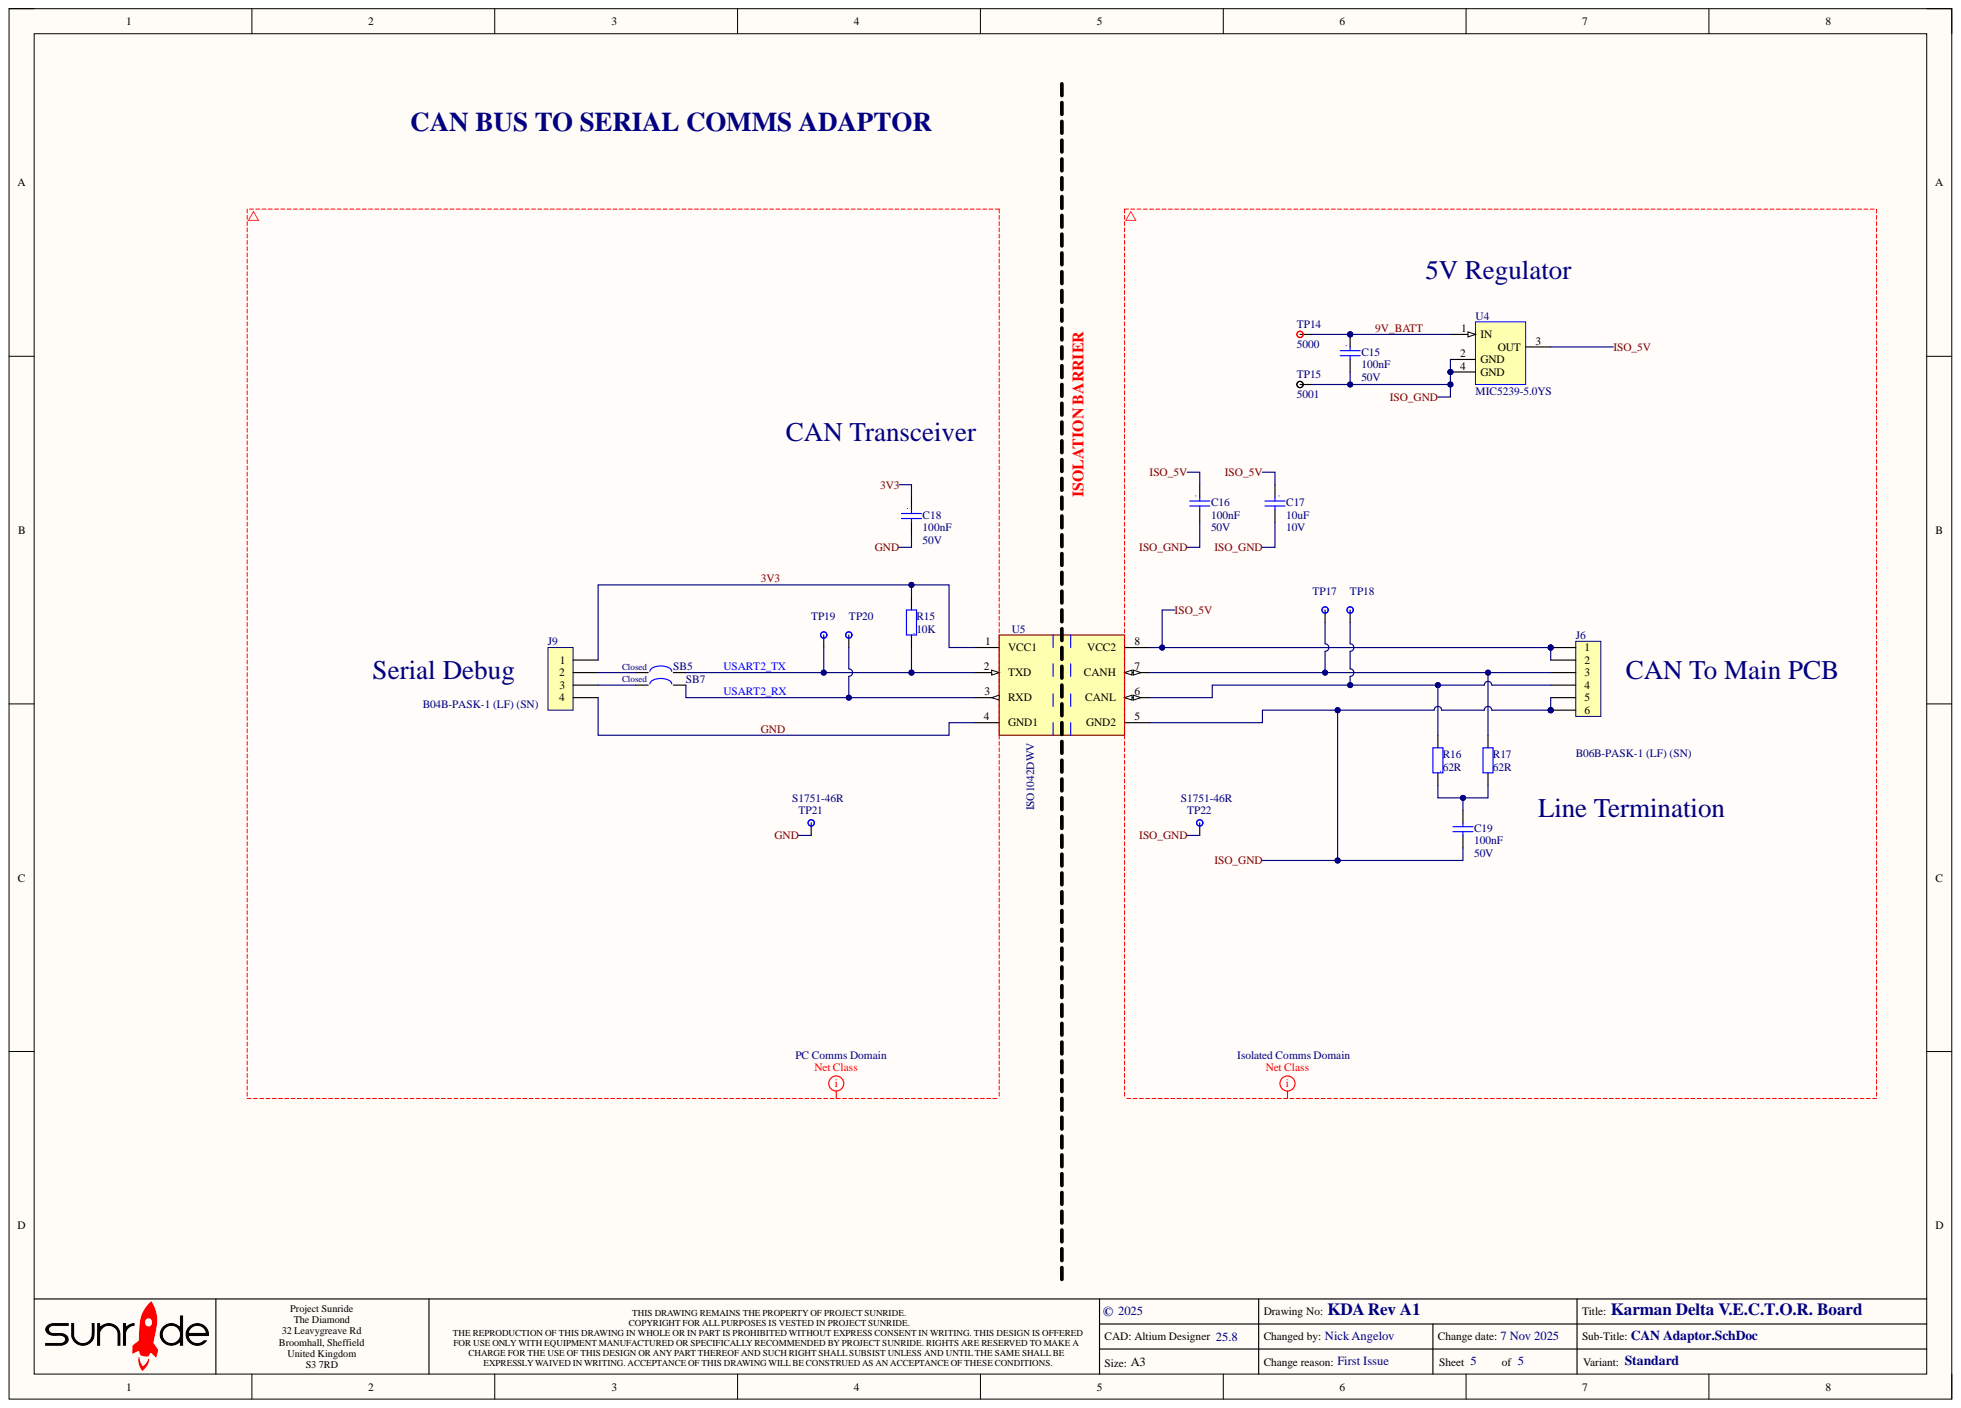
[picture p28: page 5]

CAN BUS TO SERIAL COMMS ADAPTOR
