ImNickA/AltiumGithub/Karman Delta Arm/Rev A/Assembly Outputs/Assembly Drawing/KDA Rev A1.PDF

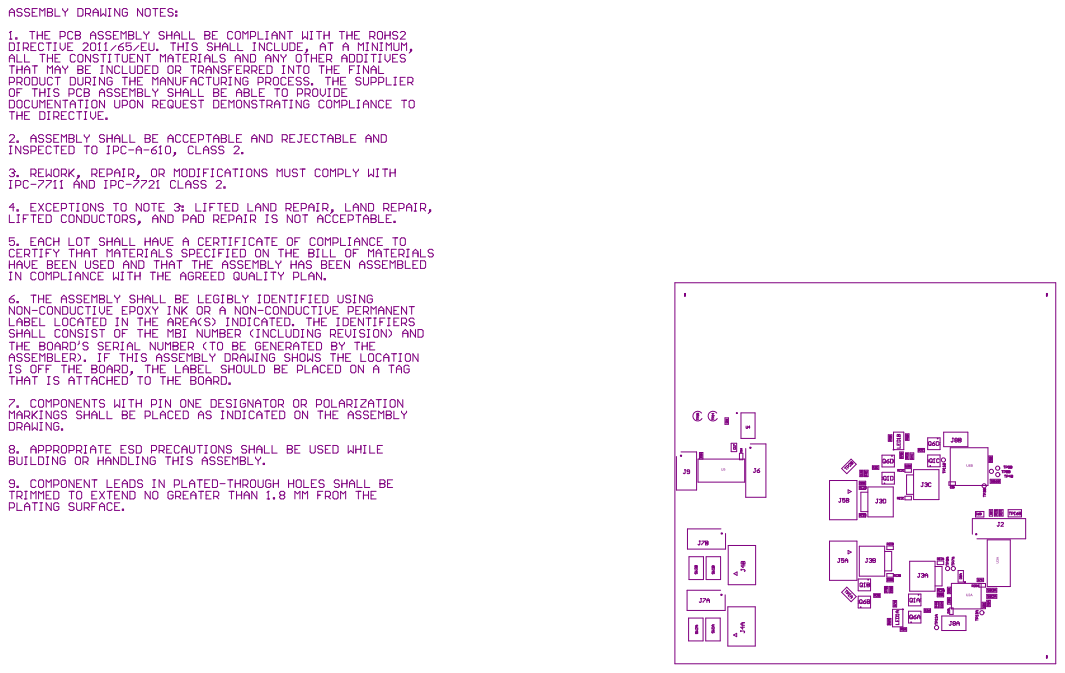
[picture p42: page 1]

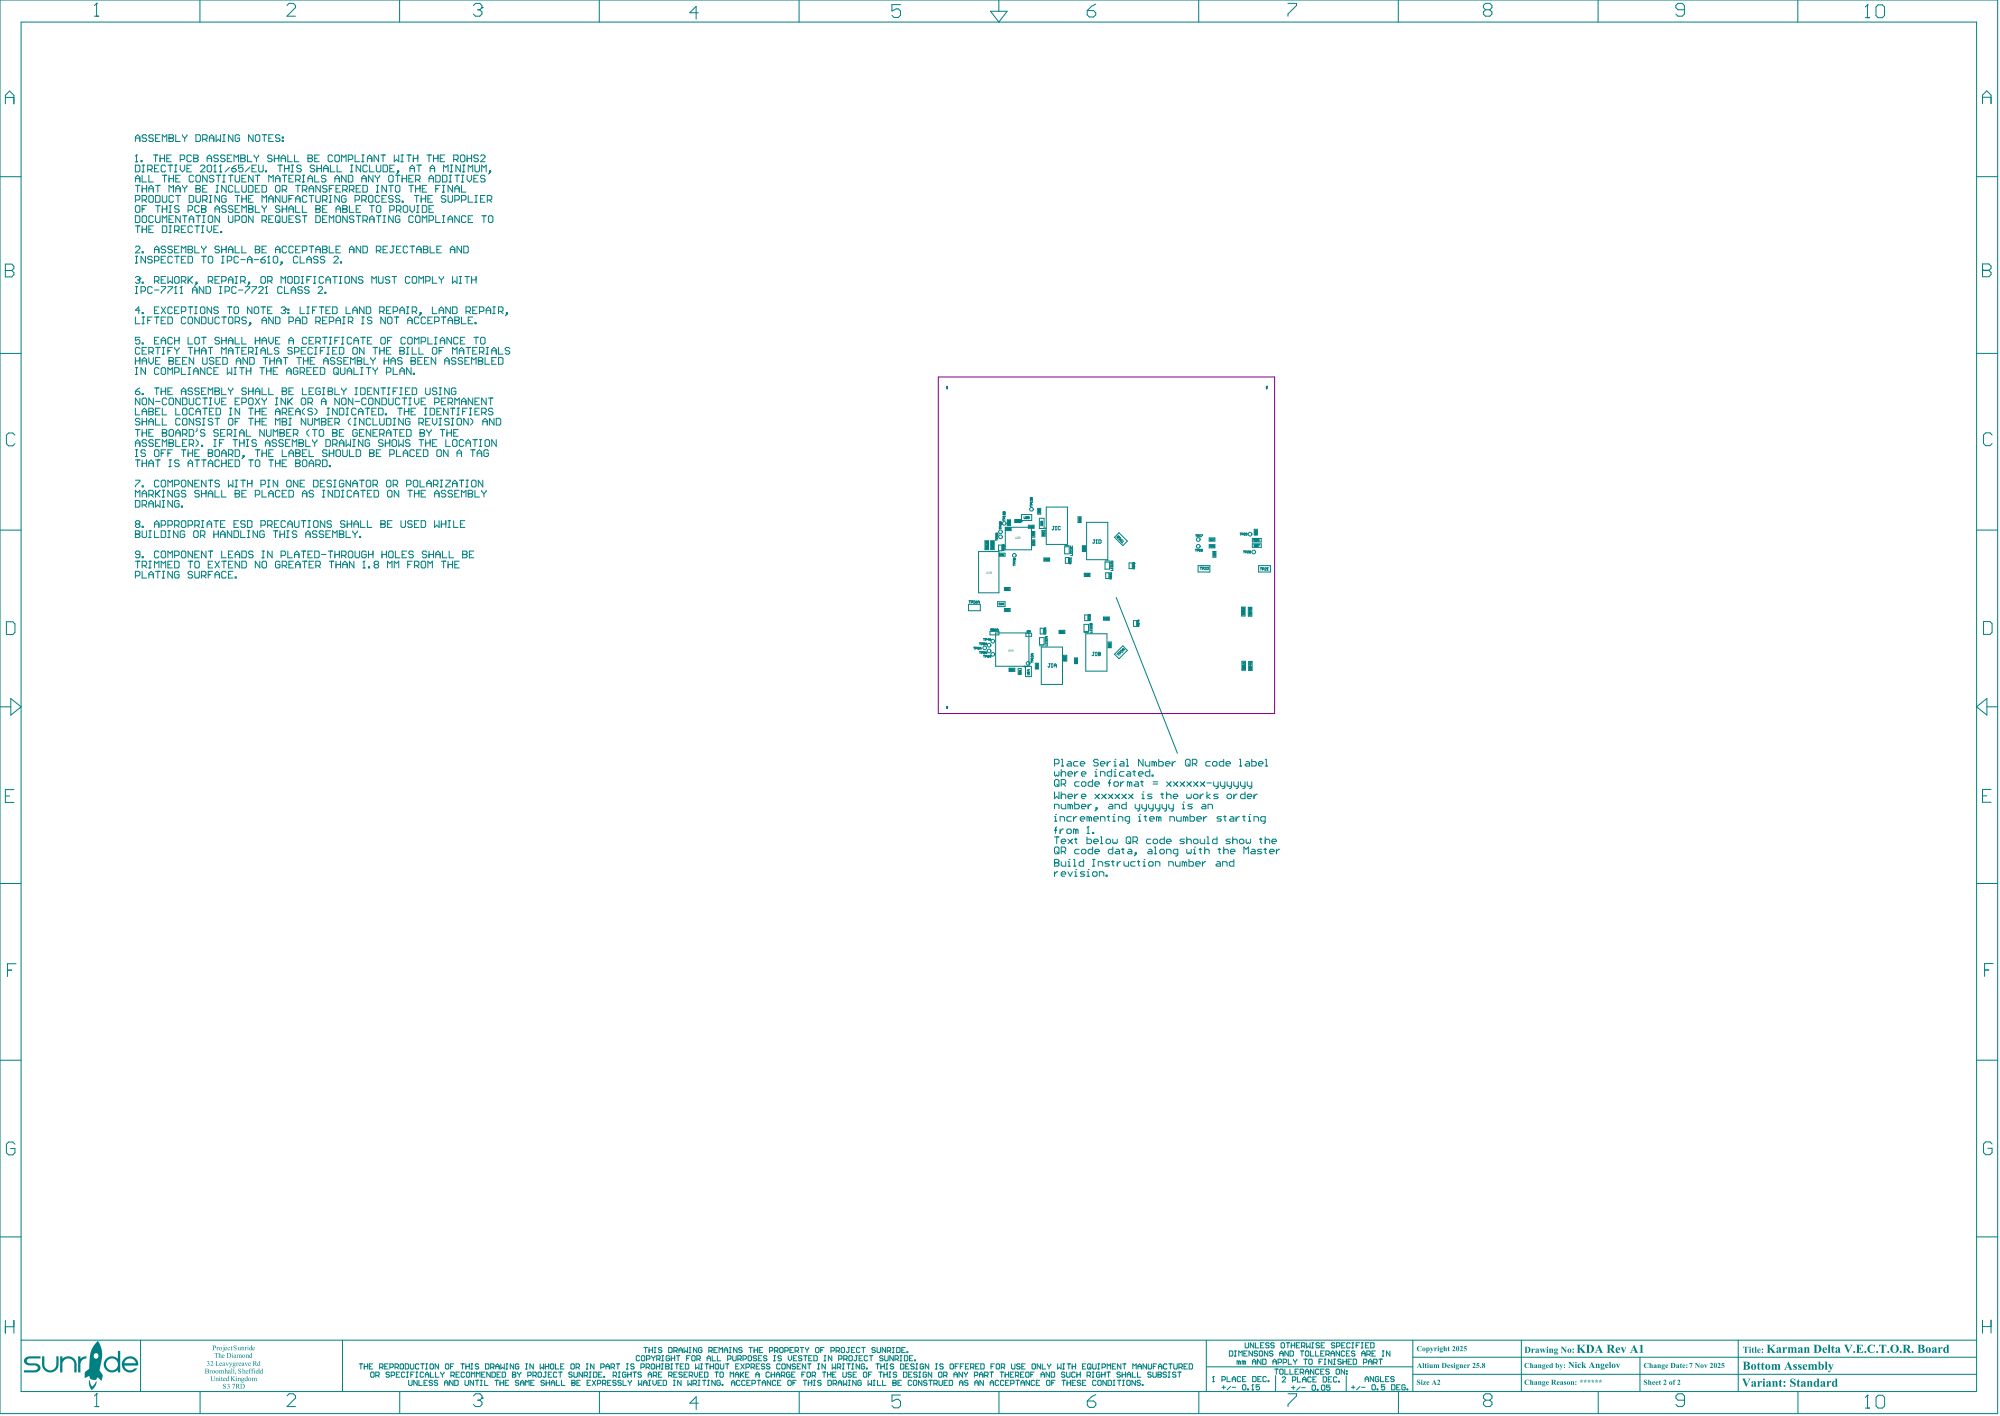
[picture p43: page 2]
