ImNickA/AltiumGithub/(list of files, drawings)

Other design files:
Karman Delta Arm/Rev A/Ancillaries.SchDoc
Karman Delta Arm/Rev A/CAN Adaptor.SchDoc
Karman Delta Arm/Rev A/Circular PCB - Radial.PcbDoc
Karman Delta Arm/Rev A/Karman Delta Arm.PrjPcb
Karman Delta Arm/Rev A/Microcontroller.SchDoc
Karman Delta Arm/Rev A/Output Stages.SchDoc
Karman Delta Arm/Rev A/PCB - Rectangular Longer.PcbDoc
Karman Delta Arm/Rev A/PCB - Rectangular.PcbDoc
Karman Delta Arm/Rev A/PCB.PcbDoc
Karman Delta Arm/Rev A/Top Sheet.SchDoc
Karman Delta Arm/Rev B/Ancillaries.SchDoc
Karman Delta Arm/Rev B/CAN Adaptor.SchDoc
Karman Delta Arm/Rev B/Circular PCB.PcbDoc
Karman Delta Arm/Rev B/Karman Delta Arm Rev B.PrjPcb
Karman Delta Arm/Rev B/Microcontroller.SchDoc
Karman Delta Arm/Rev B/Output Stages.SchDoc
Karman Delta Arm/Rev B/Top Sheet.SchDoc
