ImNickA/AltiumGithub/(commit log)

2025-10-18 1st commit
    [Assembly Release Authorisation.xlsx, BOM Template.xlsx, Karman Delta Arm.PrjPcb, Microcontroller.SchDoc, Output Stages.SchDoc, PCB Fabrication Release Authorisation.xlsx, Rocket arming system OLD.xlsx, Rocket arming system.xlsx]
2025-10-18 output stages routed
    [Microcontroller.SchDoc]
2025-10-19 track & gap rules sorted last few Rs & Cs placed
2025-10-19 Serial debug connector changed to surface mount
    [Microcontroller.SchDoc]
2025-10-19 Serial Debug connectors imported
2025-10-20 Linked most traces on both primary and secondary
2025-10-20 made traces thinner and fixed weird ones
2025-10-20 BOM created
    [Karman Delta Arm.PrjPcb]
2025-10-20 did some bits on bom
    [Output Stages.SchDoc]
2025-10-20 Logo added ontop silkscreen
2025-10-21 Restructured to take seriall debug, reset sw & boot sw off board - will be snap off section
    [Ancillaries.SchDoc, Karman Delta Arm.PrjPcb, Microcontroller.SchDoc, Rocket arming system.xlsx]
2025-10-22 FFC pinout optimised
    [Ancillaries.SchDoc, Microcontroller.SchDoc]
2025-10-22 Tweaks imported to PCB
    [Microcontroller.SchDoc]
2025-10-22 Some more tracking
    [Karman Delta Arm.PrjPcb, Microcontroller.SchDoc, Output Stages.SchDoc]
2025-10-23 added to to do list
    [Rocket arming system.xlsx]
2025-10-27 Did some more traces
2025-10-29 All routed (apart from spurious error generated from isolation keepouts - need to resolve)
    [Karman Delta Arm.PrjPcb]
2025-10-29 100mm board area box added
2025-10-30 Board shape changed to 100mm x 100mm Cutouts added to break out individual sections
    [Rocket arming system.xlsx]
2025-10-30 Breakout holes added to prevent polypours from escaping circle
2025-10-30 Solder Blob error removed
2025-10-31 DRC errors removed Cutouts improved Logo test added
    [Rocket arming system.xlsx, Top Sheet.SchDoc]
2025-11-01 Save pre change of bus driver
2025-11-01 WIP - redoing transceivers
    [Microcontroller.SchDoc, Output Stages.SchDoc, Top Sheet.SchDoc]
2025-11-02 FFC Cable added
    [Ancillaries.SchDoc, Top Sheet.SchDoc]
2025-11-02 CAN adaptor to PC added
    [Ancillaries.SchDoc, CAN Adaptor.SchDoc, Karman Delta Arm.PrjPcb, Top Sheet.SchDoc]
2025-11-03 CAN Adaptor placed & tracked - neesd poly pours adding Logos added Need to sort fob routing
    [CAN Adaptor.SchDoc, Karman Delta Arm.PrjPcb, Rocket arming system.xlsx, Top Sheet.SchDoc]
2025-11-03 Only Logo outline to sort
    [Top Sheet.SchDoc]
2025-11-03 Keyring hole added Silkscreen logos added
2025-11-07 OutJobs configured - test outputs generated
    [CAN Adaptor.SchDoc, Karman Delta Arm.PrjPcb, Output Stages.SchDoc, Top Sheet.SchDoc]
2025-11-08 Almost done - needs board stackup from PCB fab
    [Rocket arming system.xlsx]
2025-11-08 outputs initially run - need t ochange stackup, but otherwise ok
    [BOM Template.xlsx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]
2025-11-10 Camera control pads added
    [Microcontroller.SchDoc, Rocket arming system.xlsx]
2025-11-10 Final outputs generated
    [KDA Rev A.GBL, KDA Rev A.GBO, KDA Rev A.GBP, KDA Rev A.GBS, KDA Rev A.GM1, KDA Rev A.GTL, KDA Rev A.GTO, KDA Rev A.GTP]
2025-11-10 3D fly-through video added to assembly outputs
    [KDA Rev A1 PCB BOM.xlsx, KDA Rev A1 Pick and Place (Variants).csv]
2025-11-20 spreadsheet updated
    [Rocket arming system.xlsx]
2025-12-16 Rev A errors identified in spreadsheet
    [KDA Rev A1 PCB BOM DO NOT USE.xlsx, KDA Rev A1 PCB BOM.xlsx, Rocket arming system.xlsx]
2025-12-26 Rev B added
    [Ancillaries.SchDoc, CAN Adaptor.SchDoc, Circular PCB - Radial.PcbDoc, Circular PCB.PcbDoc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]
2025-12-28 Mods in progress
    [Ancillaries.SchDoc, CAN Adaptor.SchDoc, Circular PCB.PcbDoc, Microcontroller.SchDoc, Output Stages.SchDoc, Top Sheet.SchDoc]
2025-12-28 ignitor current proifiles added
    [Rocket arming system.xlsx]
2025-12-28 ignitor current proifiles added (auto)
2026-01-01 Save pre changing to contraint manager workflow
    [Circular PCB.PcbDoc, Karman Delta Arm Rev B.PrjPcb]
2026-01-01 Update Rocket arming system.xlsx
    [Rocket arming system.xlsx]
2026-01-01 Update Schematic Template A3.SchDotPreview
2026-01-01 Update Schematic Template A3.SchDot
2026-01-11 Rev B schematic changes done. Commit prior to importing into PCB
    [Ancillaries.SchDoc, CAN Adaptor.SchDoc, Circular PCB.PcbDoc, Karman Delta Arm Rev B.PrjPcb, Microcontroller.SchDoc, Output Stages.SchDoc, Top Sheet.SchDoc]
2026-01-14 WIP Layout underway
    [Ancillaries.SchDoc, CAN Adaptor.SchDoc, Circular PCB.PcbDoc]
2026-01-20 ALmost complete - ready for checking Pre output generation
    [CAN Adaptor.SchDoc, Circular PCB.PcbDoc, Karman Delta Arm Rev B.PrjPcb, Microcontroller.SchDoc, Output Stages.SchDoc, Top Sheet.SchDoc]
2026-01-20 Rev B outputs generated
    [Circular PCB.PcbDoc, Karman Delta Arm Rev B.PrjPcb]
2026-01-28 Rev B outputs generated & ignitor current tests added
    Rev B outputs generated
    Spreadsheet updated with ignitor tests
    [KDA Rev B.GBL, KDA Rev B.GBO, KDA Rev B.GBP, KDA Rev B.GBS, KDA Rev B.GM1, KDA Rev B.GTL, KDA Rev B.GTO, KDA Rev B.GTP]
